radiator-revivers/BORC/Mechanical/BORC_Explode_1.PNG

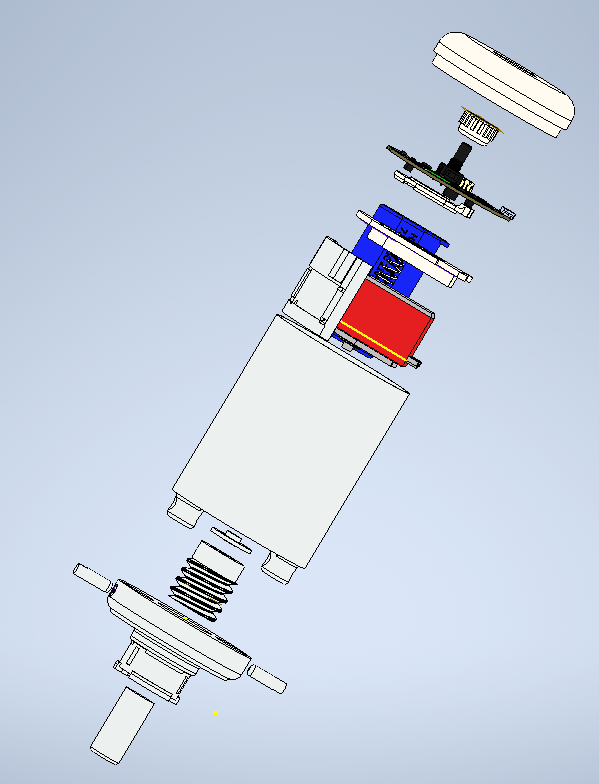
Mechanical/BORC_Explode_1.PNG
