radiator-revivers/BORC/Mechanical/BORC_Assembled.PNG

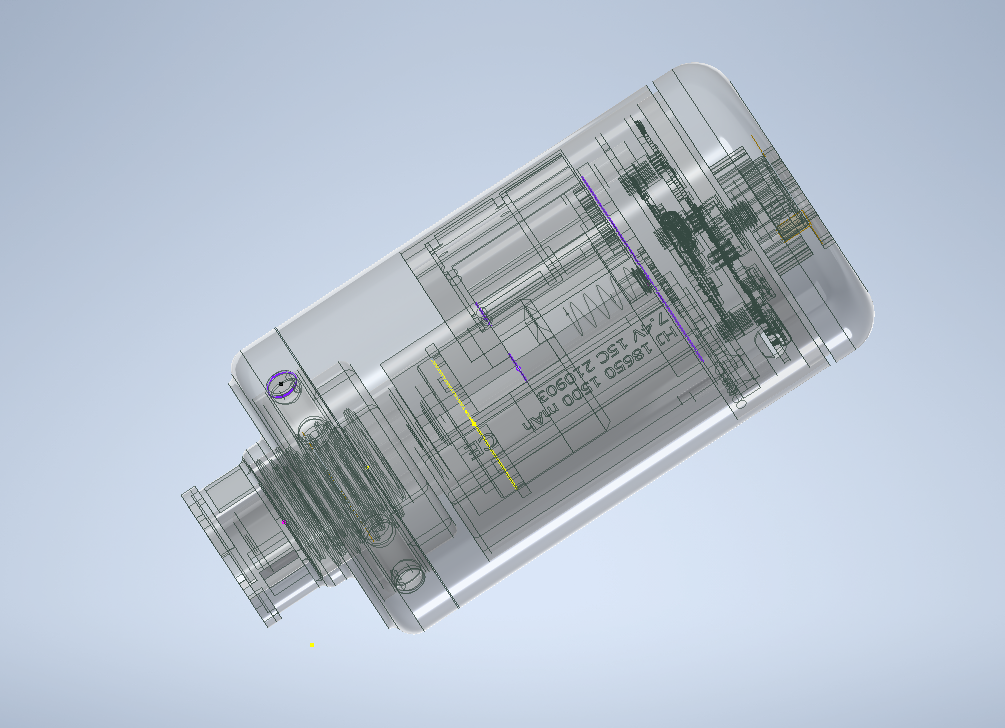
Mechanical/BORC_Assembled.PNG
