radiator-revivers/BORC/hardware/control_board/BORC_v2_control_board_render_top.png

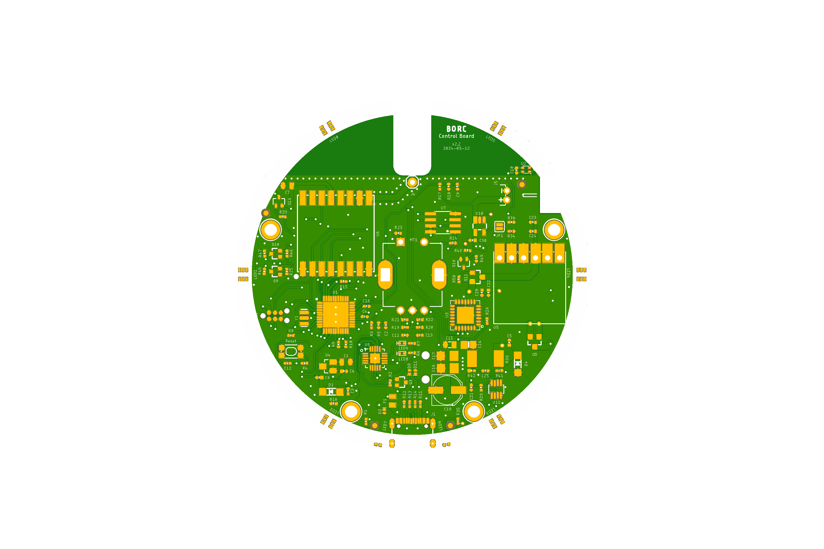
hardware/control_board/BORC_v2_control_board_render_top.png
