radiator-revivers/BORC/Mechanical/BORC_Explode.PNG

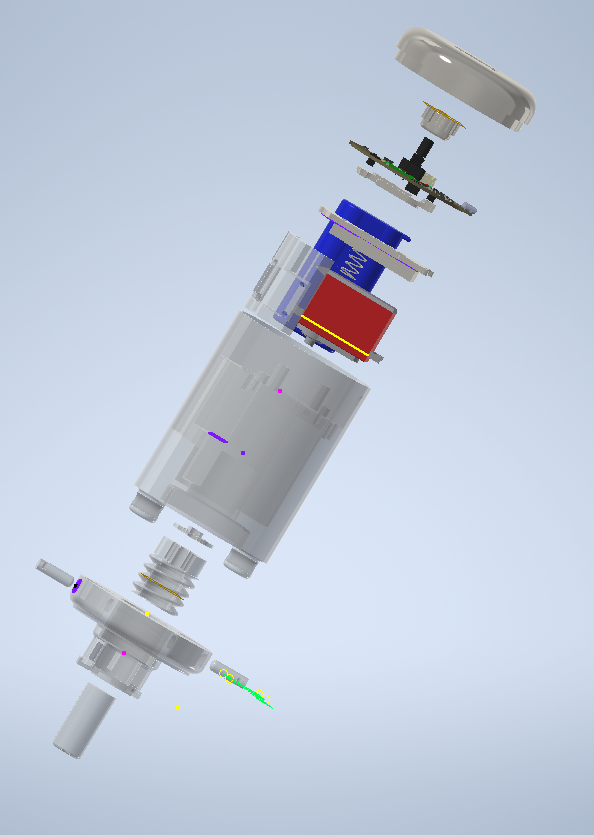
Mechanical/BORC_Explode.PNG
