radiator-revivers/BORC/hardware/control_board/BORC_v2_control_board__BOM.xlsx

Parts | Qty | Value | Manufacturer | MPN | Description
J4 | 1 |  |  |  | 915 MHz right angled helical spring antenna, 17.5 mm/0.68", 2.15 dBi gain, 50Ω impedance
R39 | 1 | 0.1/1%/2W | Vishay Dale | RCWE2512R100FKEA | 100 mOhms ±1% 2W Chip Resistor 2512 (6432 Metric) Automotive AEC-Q200, Current Sense, Moisture Resistant Thick Film
C14 | 1 | 0.1uF | YAGEO | CC0805KRX7R9BB104 | 0.1 µF ±10% 50V Ceramic Capacitor X7R 0805 (2012 Metric)
C2, C3, C4, C5, C6, C9, C10, C11, C12, C13, C18, C21, C25 | 13 | 0.1uF | Murata Electronics | GRM155R71H104KE14D | 0.1 µF ±10% 50V Ceramic Capacitor X7R 0402 (1005 Metric)
C1, C7 | 2 | 0.33µF | Murata Electronics | GRM219R71H334KA88D | 0.33 µF ±10% 50V Ceramic Capacitor X7R 0805 (2012 Metric)
R41, R42 | 2 | 10 | YAGEO | RC0402FR-0710RL | 10 Ohms ±1% 0.063W, 1/16W Chip Resistor 0402 (1005 Metric) Moisture Resistant Thick Film
R4 | 1 | 100 | YAGEO | RC0402FR-07100RL | 100 Ohms ±1% 0.063W, 1/16W Chip Resistor 0402 (1005 Metric) Moisture Resistant Thick Film
C19 | 1 | 100uF | KEMET | A768EB107M1ELAS036 | 100 µF 25 V Aluminum - Polymer Capacitors Radial, Can - SMD 36mOhm 2000 Hrs @ 125°C
R2, R8, R15, R16, R19, R20, R21, R22, R23, R24, R25, R29, R35, R45, R46, R47, R49, R50 | 18 | 10K | YAGEO | RC0402FR-7W10KL | 10 kOhms ±1% 0.125W, 1/8W Chip Resistor 0402 (1005 Metric) Moisture Resistant Thick Film
R3, R5, R17, R18 | 4 | 10M | YAGEO | RC0402FR-0710ML | 10 MOhms ±1% 0.063W, 1/16W Chip Resistor 0402 (1005 Metric) Moisture Resistant Thick Film
C15 | 1 | 10uF | Murata Electronics | GRM21BR61H106KE43L | 10 µF ±10% 50V Ceramic Capacitor X5R 0805 (2012 Metric)
C8, C20, C22, C23, C24, C30 | 5 | 10uF | Murata Electronics | GRM21BR61H106KE43L | 10 µF ±10% 50V Ceramic Capacitor X5R 0805 (2012 Metric)
Y1 | 1 | 16 MHz | Murata Electronics | CSTNE16M0V530000R0 | 16 MHz Ceramic Resonator Built in Capacitor 15 pF ±0.3% 40 Ohms -40°C ~ 85°C Surface Mount
R1, R6, R7, R33, R48 | 5 | 1K | YAGEO | RC0402FR-071KL | 1 kOhms ±1% 0.063W, 1/16W Chip Resistor 0402 (1005 Metric) Moisture Resistant Thick Film
R34, R36 | 2 | 2K | YAGEO | RC0402FR-072KL | 2 kOhms ±1% 0.063W, 1/16W Chip Resistor 0402 (1005 Metric) Moisture Resistant Thick Film
C16, C17 | 2 | 2.2uF | KEMET | C1206C225K5RAC7800 | 2.2 µF ±10% 50V Ceramic Capacitor X7R 1206 (3216 Metric)
R26 | 1 | 220 | YAGEO | RC0402FR-13220RL | 220 Ohms ±1% 0.063W, 1/16W Chip Resistor 0402 (1005 Metric) Moisture Resistant Thick Film
R13, R14 | 2 | 27 | YAGEO | RC0402FR-0727RL | 27 Ohms ±1% 0.063W, 1/16W Chip Resistor 0402 (1005 Metric) Moisture Resistant Thick Film
R9, R10 | 2 | 4.7K | YAGEO | RC0402FR-074K7L | 4.7 kOhms ±1% 0.063W, 1/16W Chip Resistor 0402 (1005 Metric) Moisture Resistant Thick Film
R11, R12 | 2 | 5.1K | YAGEO | RC0402FR-135K1L | 5.1 kOhms ±1% 0.063W, 1/16W Chip Resistor 0402 (1005 Metric) Thick Film
F1 | 1 | 6V 1.1A | Bourns Inc. | MF-PSML110/6-2 | Polymeric PTC Resettable Fuse 6V 1.1 A Ih Surface Mount 0805 (2012 Metric), Concave
U6 | 1 | 915MHz | HOPERF | RFM69HCW | HOPERF RFM69H ISM Transceiver Module General ISM 915MHz Surface Mount
LED0, LED1, LED2, LED3, LED4, LED5 | 6 | APA102-2020 | Shenzhen LED Color Opto Electronic CO.,LTD | APA102-2020 | APA102-2020 Super LED/DotStar Pixels
U7 | 1 | W25X40CLSNIG | Winbond Electronics | W25X40CLSNIG | FLASH Memory IC 4Mbit SPI 104 MHz 8-SOIC
U1 | 1 | ATMEGA1284P-MU | Microchip Technology | ATMEGA1284P-MU | AVR AVR® ATmega Microcontroller IC 8-Bit 20MHz 128KB (64K x 16) FLASH 44-VQFN (7x7)
Q3, Q9, Q10 | 3 | BSS138PW,115 | Nexperia USA Inc. | BSS138PW,115 | N-Channel 60 V 320mA (Ta) 260mW (Ta), 830mW (Tc) Surface Mount SOT-323
U8 | 1 | FT231XQ-R | FTDI, Future Technology Devices International Ltd | FT231XQ-R | USB Bridge, USB to UART USB 2.0 UART Interface 20-QFN (4x4)
LED8 | 1 | GREEN | Inolux | IN-S42ATG | Green 525nm LED Indication - Discrete 3.3V 0402 (1005 Metric)
U11 | 1 | INA219AIDCNR | Texas Instruments | INA219AIDCNR | Current Monitor Regulator High-Side 10mA SOT-23-8
J3 | 1 | M20-8900405 | Harwin Inc. | M20-8900405 | Connector Header Surface Mount, Right Angle 4 position 0.100" (2.54mm)
D4 | 1 | 60V, 2A | SMC Diode Solutions | MBR260HW | Diode 60 V 2A Surface Mount SOD-123
D1 | 1 | 40V, 1A | STMicroelectronics | STPS140Z | Diode 40 V 1A Surface Mount SOD-123
U4 | 1 | 3.3V, 250mA | Microchip Technology | MCP1703T-3302E/CB | Linear Voltage Regulator IC Positive Fixed 1 Output 250mA SOT-23A-3
U10 | 1 | MCP73831T-2ACI/OT | Microchip Technology | MCP73831T-2ACI/OT | Charger IC Lithium Ion/Polymer SOT-23-5
U3 | 1 | PCA9685 | NXP USA Inc. | PCA9685BS,118 | LED Driver IC 16 Output Linear PWM Dimming 25mA 28-HVQFN (6x6)
MT1 | 1 | PEC11R-4215F-S0024 | Bourns Inc. | PEC11R-4215F-S0024 | Rotary Encoder Mechanical 24 Quadrature (Incremental) Vertical
U5 | 1 | 4012 | Pololu Corporation | U3V40F5 | Non-Isolated PoL Module DC DC Converter 1 Output 5V 3.5A 1.3V - 5V Input
J2 | 1 | 4 POS 1mm | JST Sales America Inc. | SM04B-SRSS-TB(LF)(SN) | Connector Header Surface Mount, Right Angle 4 position 0.039" (1.00mm)
LED6, LED7 | 2 | RED | Inolux | IN-S42ATR | Red 631nm LED Indication - Discrete 2.1V 0402 (1005 Metric)
J5 | 1 | 2 POS 2.0mm | JST Sales America Inc. | S2B-PH-K-S | Connector Header Through Hole, Right Angle 2 position 0.079" (2.00mm)
U2 | 1 | SHT40-BD1B | Sensirion AG | SHT40-BD1B-R3 | Humidity, Temperature 0 ~ 100% RH I²C ±1.8% RH 6 s Surface Mount
D2, D9, D11 | 3 | SP0402U-ULC-01ETG | Littelfuse Inc. | SP0402U-ULC-01ETG | 9.2V (Typ) Clamp 2A (8/20µs) Ipp Tvs Diode Surface Mount 0402/2DFN (1x0.60)
SW1 | 1 | SPST-NO 50mA 32V | C&K | KMR221GLFS | Tactile Switch SPST-NO Top Actuated Surface Mount
Q5, Q11 | 2 | P-CH 30V 4A SOT23F | Toshiba Semiconductor and Storage | SSM3J374R,LF | P-Channel 30 V 4A (Ta) 1W (Ta) Surface Mount SOT-23F
Q16 | 1 | BJT NPN 40V 0.2A | Rohm Semiconductor | UMT3904T106 | Bipolar (BJT) Transistor NPN 40 V 200 mA 300MHz 200 mW Surface Mount UMT3
Q14 | 1 | BJT PNP 40V 0.2A | Rohm Semiconductor | UMT3906T106 | Bipolar (BJT) Transistor PNP 40 V 200 mA 250MHz 200 mW Surface Mount UMT3
J1 | 1 | CONN RCP USB2.0 TYP C 24P SMD RA | GCT | USB4105-GF-A | USB-C (USB TYPE-C) USB 2.0 Receptacle Connector 24 (16+8 Dummy) Position Surface Mount, Right Angle; Through Hole
LED9 | 1 | YELLOW | Inolux | IN-S42ATY | Yellow 592nm LED Indication - Discrete 1.9V 0402 (1005 Metric)
