radiator-revivers/BORC/hardware/LED_Board/LED_Board_BOM.xlsx

Parts | Qty | Value | Manufacturer | MPN | Description
LED1, LED2, LED3, LED4, LED5, LED6, LED7, LED8, LED9, LED10, LED11, LED12, LED13, LED14, LED15, LED16, LED17, LED18, LED19, LED20, LED21, LED22, LED23, LED24, LED25, LED26, LED27, LED28, LED29, LED30, LED31, LED32, LED33, LED34, LED35, LED36, LED37, LED38, LED39, LED40, LED41, LED42, LED43, LED44, LED45, LED46, LED47, LED48, LED49, LED50, LED51, LED52, LED53, LED54, LED55, LED56, LED57, LED58, LED59, LED60, LED61, LED62, LED63, LED64, LED65, LED66, LED67, LED68, LED69, LED70, LED71, LED72, LED73, LED74, LED75, LED76, LED77, LED78, LED79, LED80, LED81, LED82, LED83, LED84, LED85, LED86, LED87, LED88, LED89, LED90, LED91, LED92, LED93, LED94, LED95, LED96, LED97, LED98, LED99, LED100, LED101, LED102, LED103, LED104, LED105 | 105 | White | Inolux | IN-S42ATUW | White LED Indication - Discrete 3.1V 0402 (1005 Metric)
C1, C2 | 2 | 0.1uF | Murata Electronics | GRM155R71C104KA88J | 0.1 µF ±10% 16V Ceramic Capacitor X7R 0402 (1005 Metric)
R1, R2, R3, R4 | 4 | 10K | YAGEO | RC0402FR-7W10KL | 10 kOhms ±1% 0.125W, 1/8W Chip Resistor 0402 (1005 Metric) Moisture Resistant Thick Film
C3, C7 | 2 | 10uF | Murata Electronics | GRM155R71C104KA88J | 0.1 µF ±10% 16V Ceramic Capacitor X7R 0402 (1005 Metric)
U1 | 1 | LED Driver | Lumissil Microsystems | IS31FL3731-QFLS2-TR | LED Driver IC 18 Output Linear Analog Dimming 34mA 28-QFN (4x4)
J2 | 1 | QWIIC_RIGHT_ANGLE | JST Sales America Inc. | SM04B-SRSS-TB(LF)(SN) | Connector Header Surface Mount, Right Angle 4 position 0.039" (1.00mm)
