radiator-revivers/BORC/hardware/control_board/BORC_v2_control_board__schematic.pdf

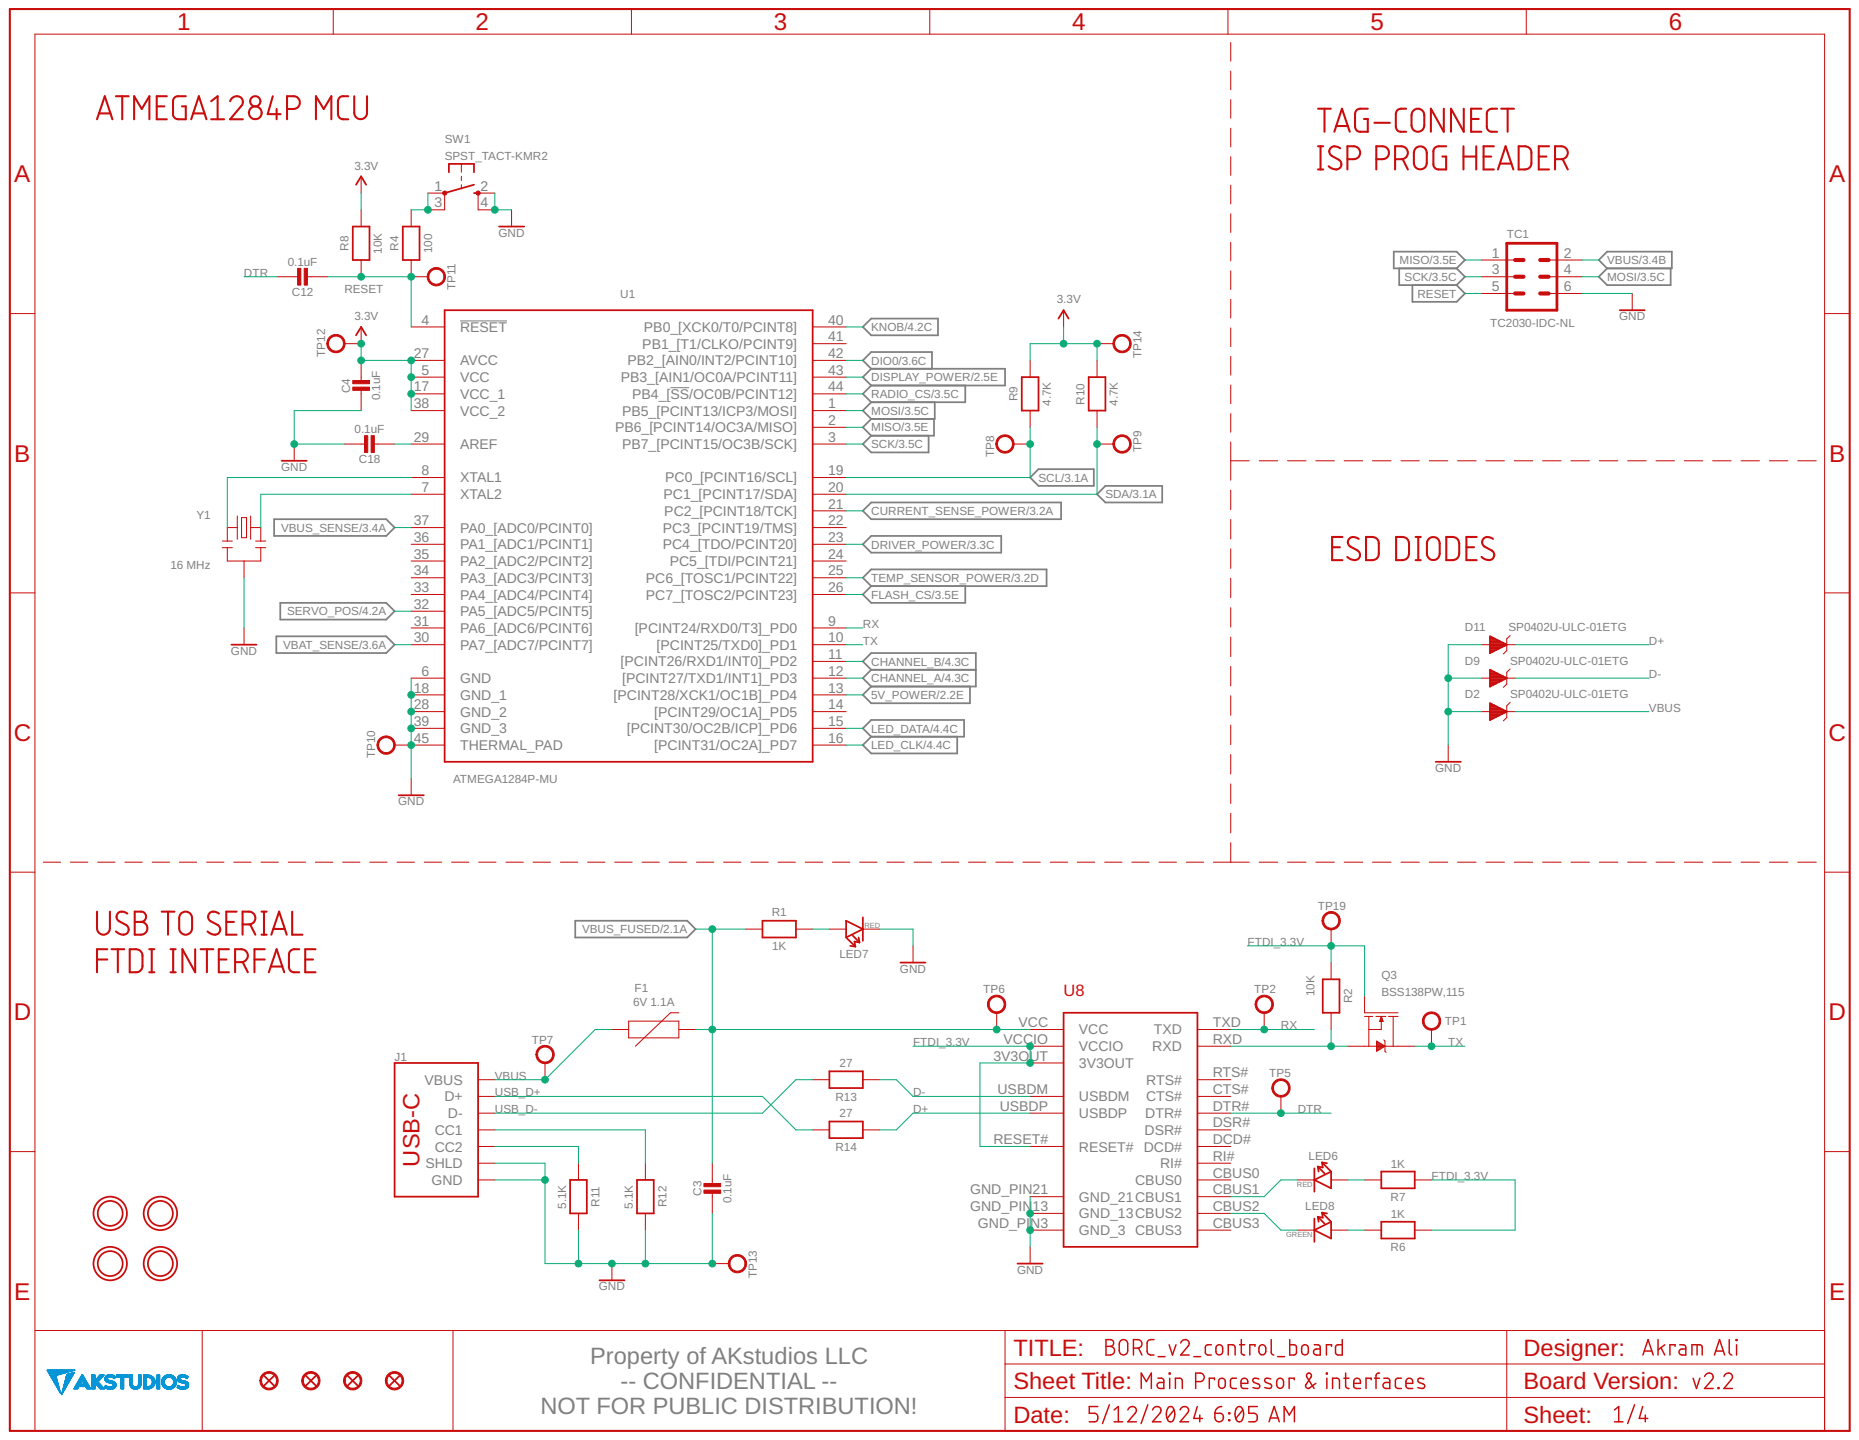
[picture p6: page 1]

Property of AKstudios LLC -- CONFIDENTIAL -- NOT FOR PUBLIC DISTRIBUTION!

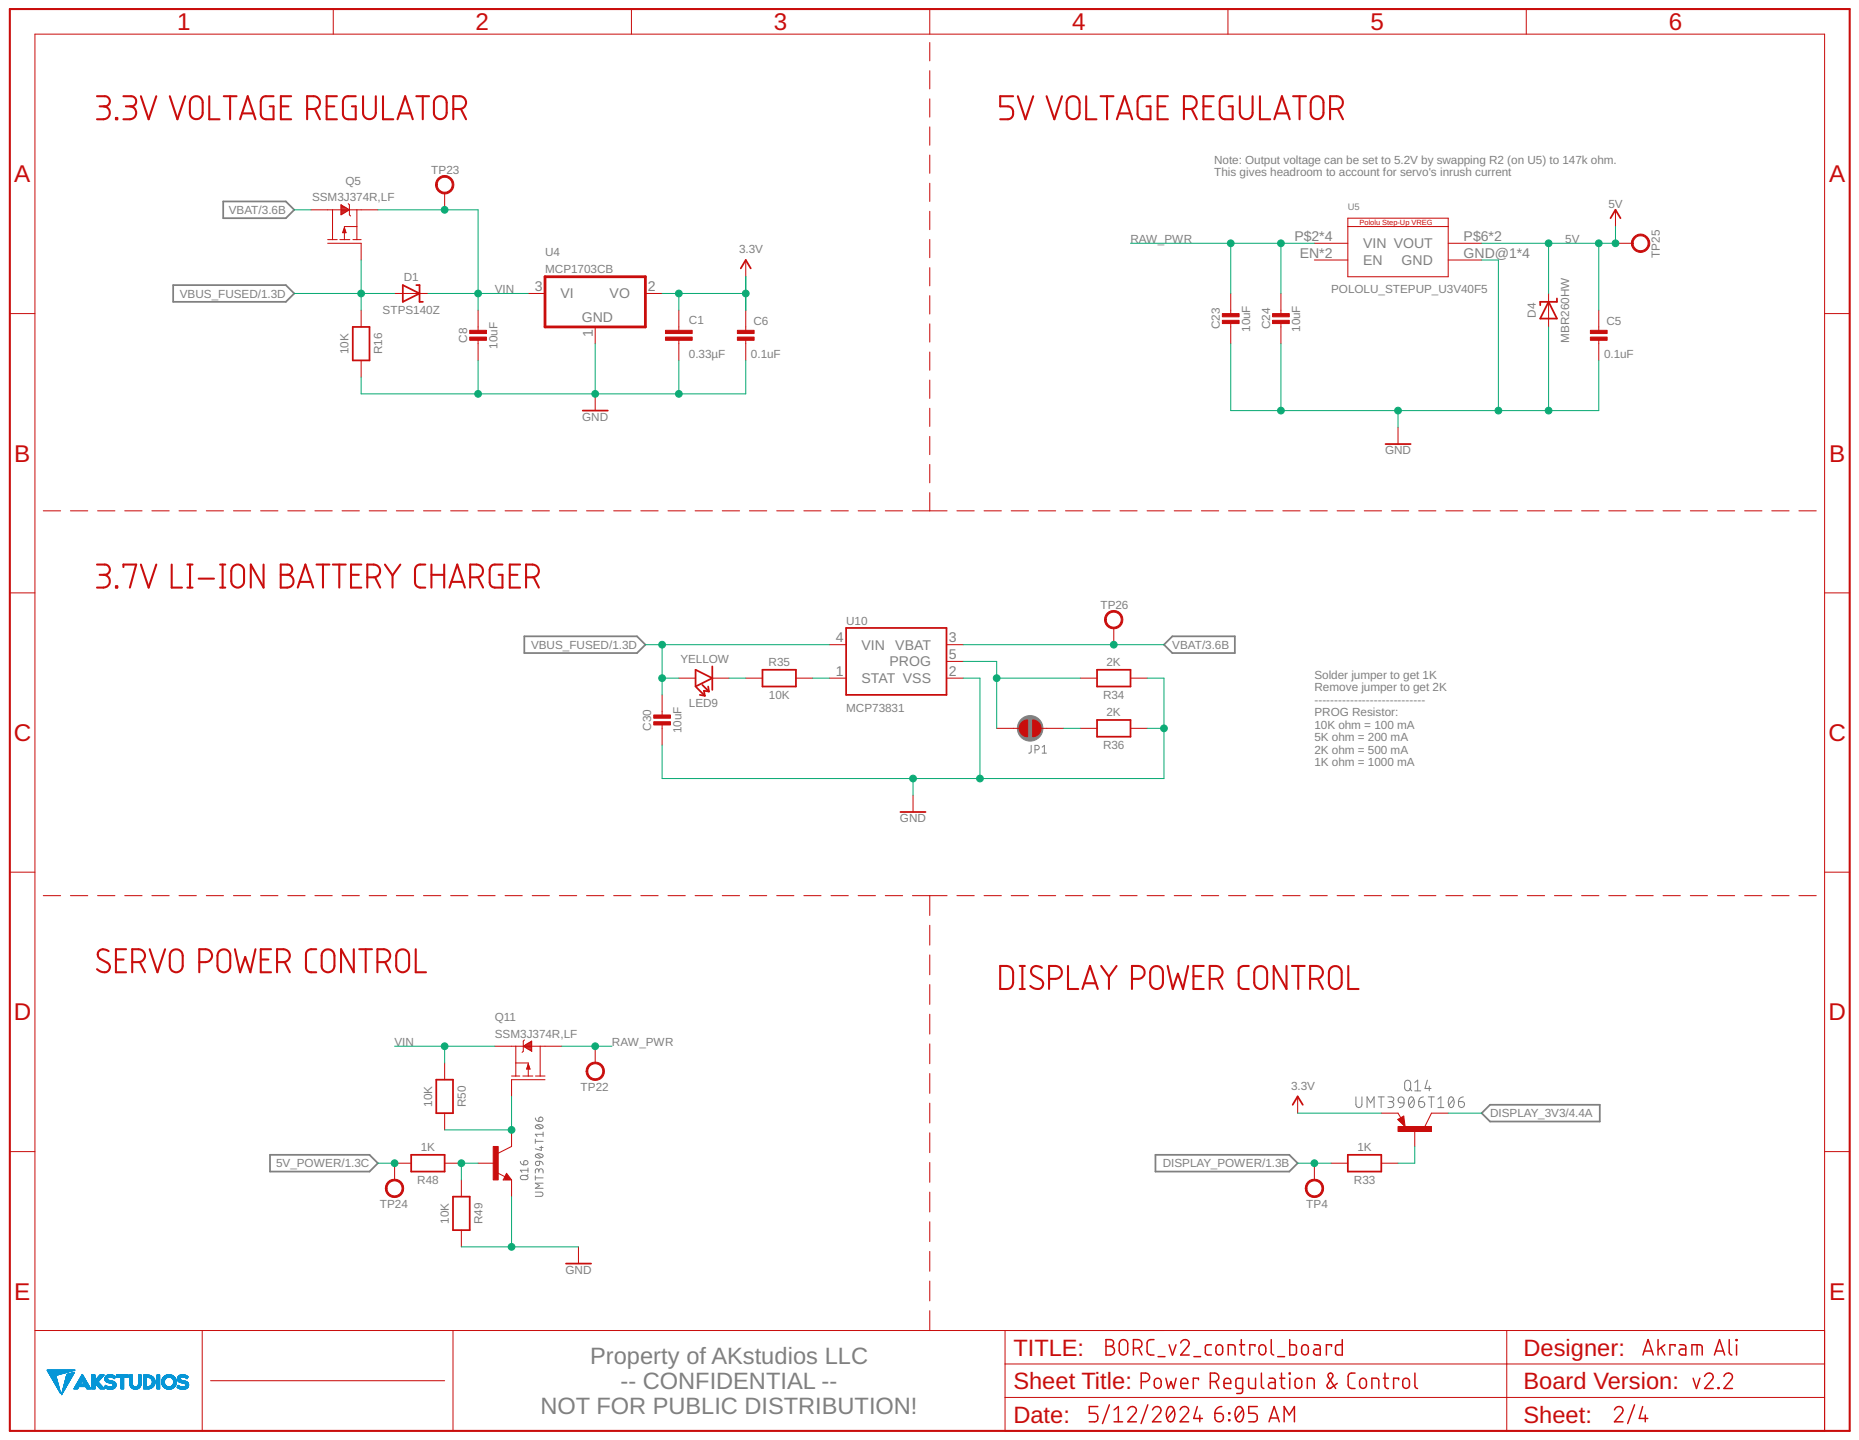
[picture p7: page 2]

Note: Output voltage can be set to 5.2V by swapping R2 (on U5) to 147k ohm. This gives headroom to account for servo's inrush current

Pololu Step-Up VREG

Solder jumper to get 1K Remove jumper to get 2K

---------------------------- PROG Resistor: 10K ohm = 100 mA

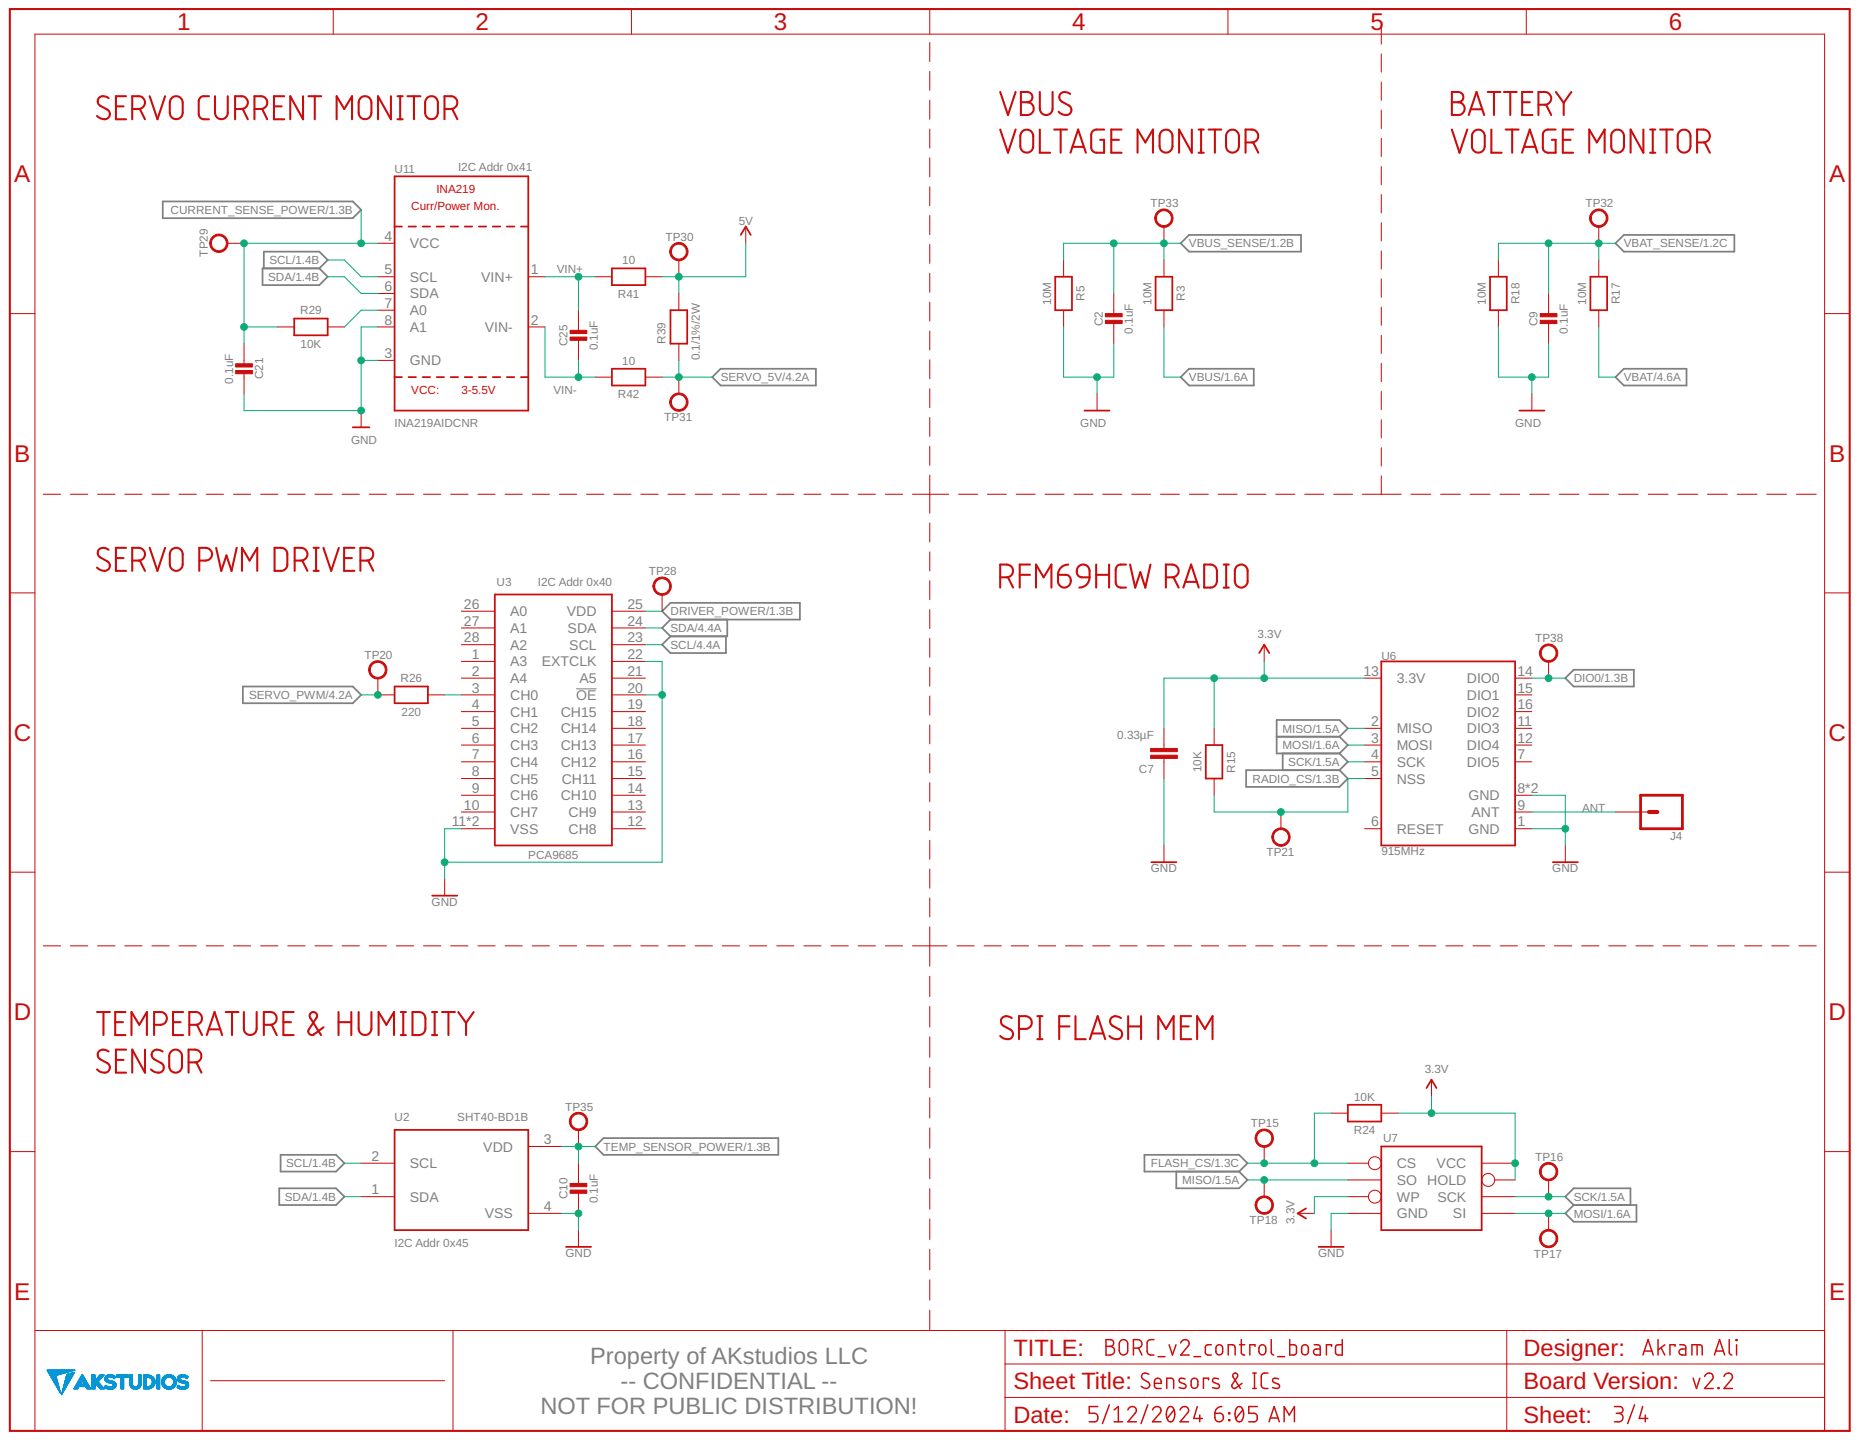
[picture p8: page 3]

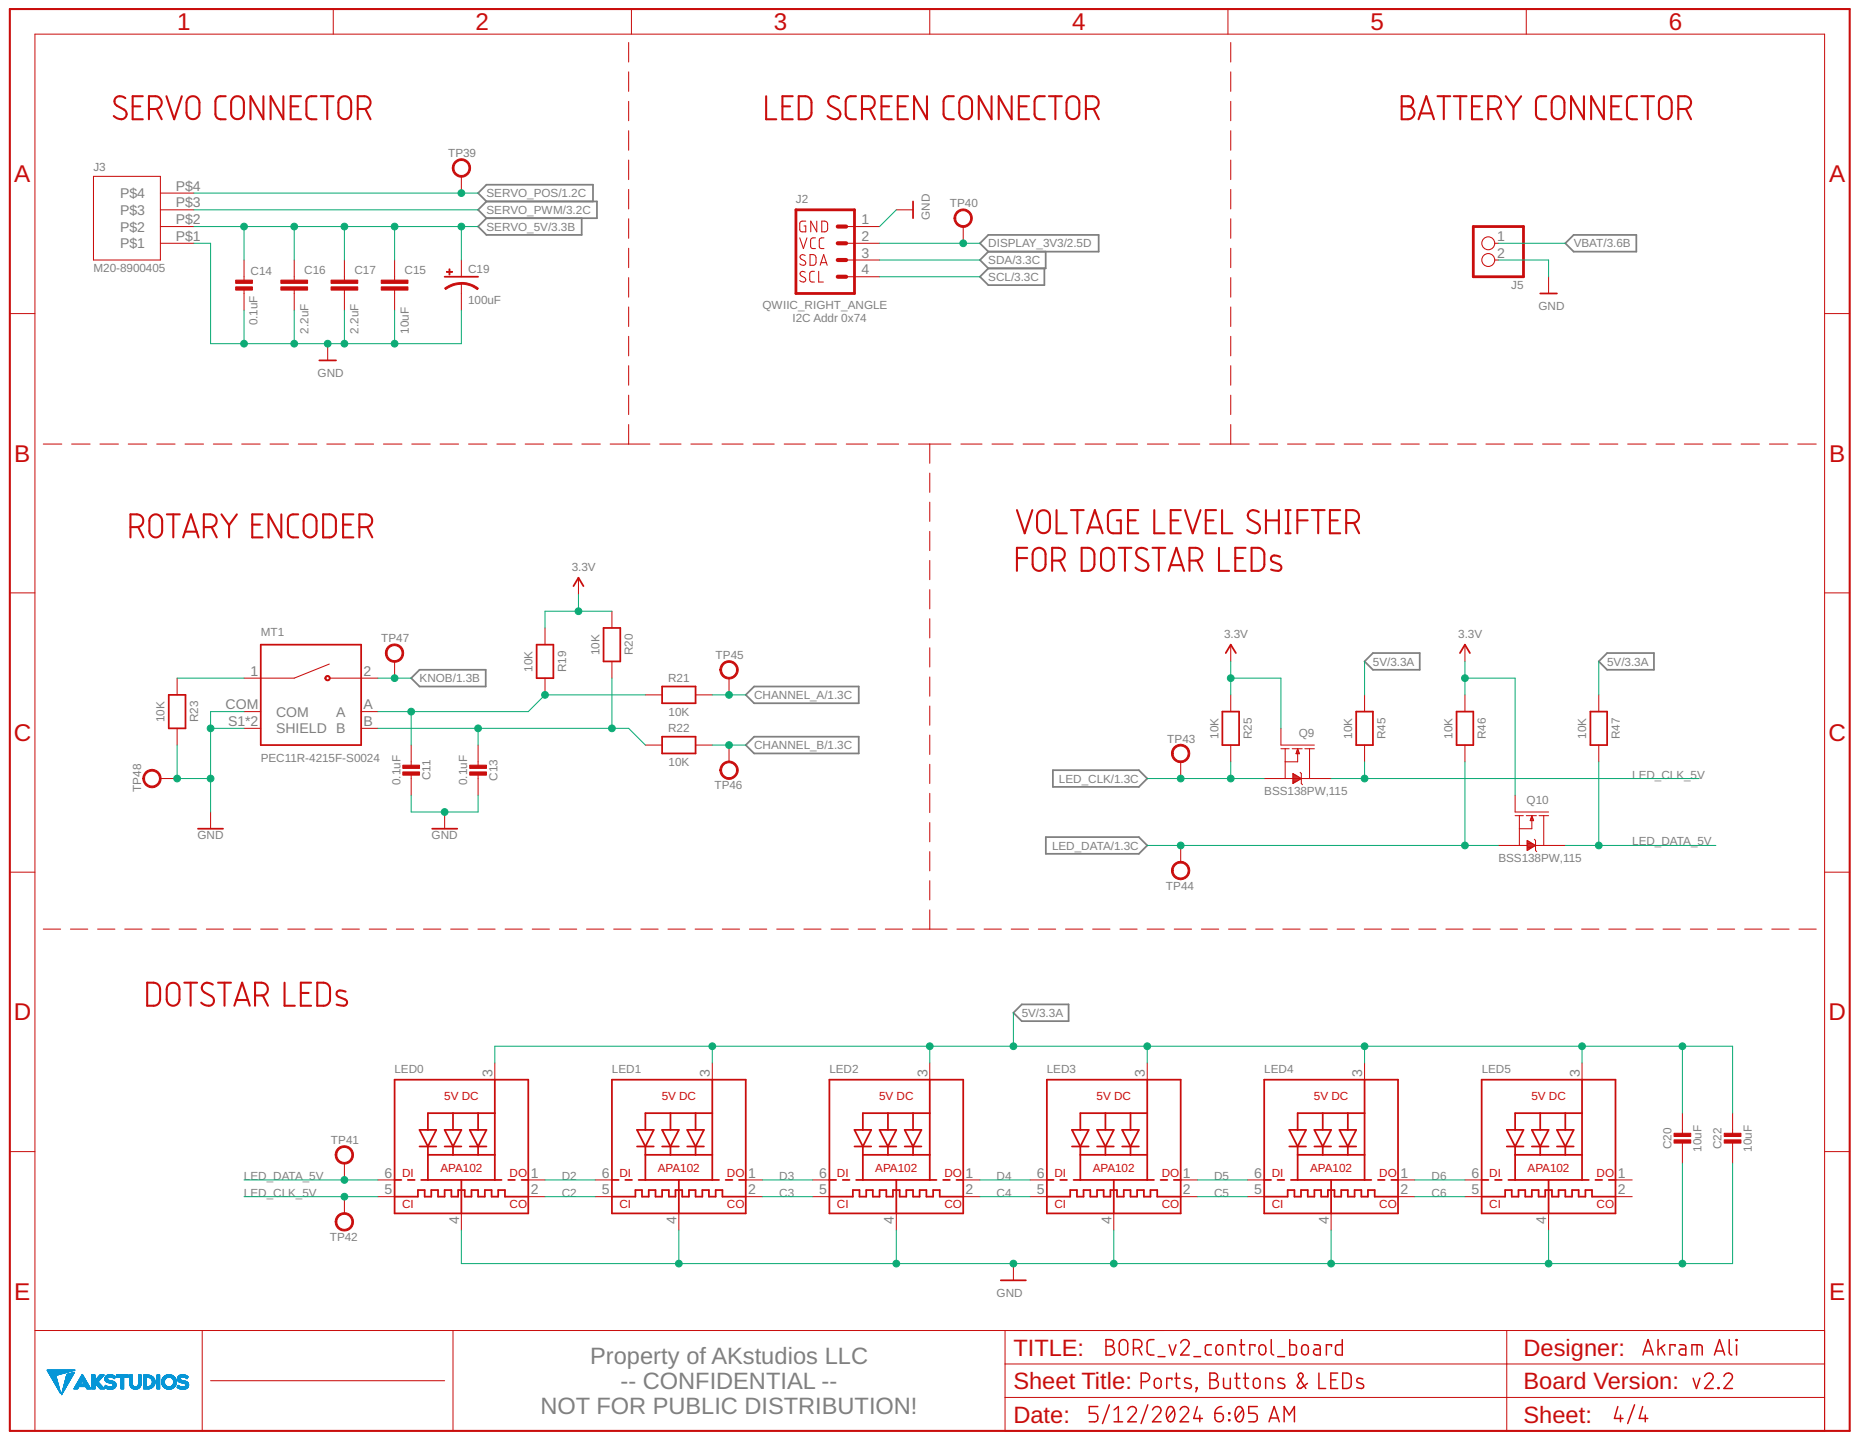
[picture p9: page 4]
