radiator-revivers/BORC/hardware/control_board/BORC_v2_control_board__dimensions.pdf

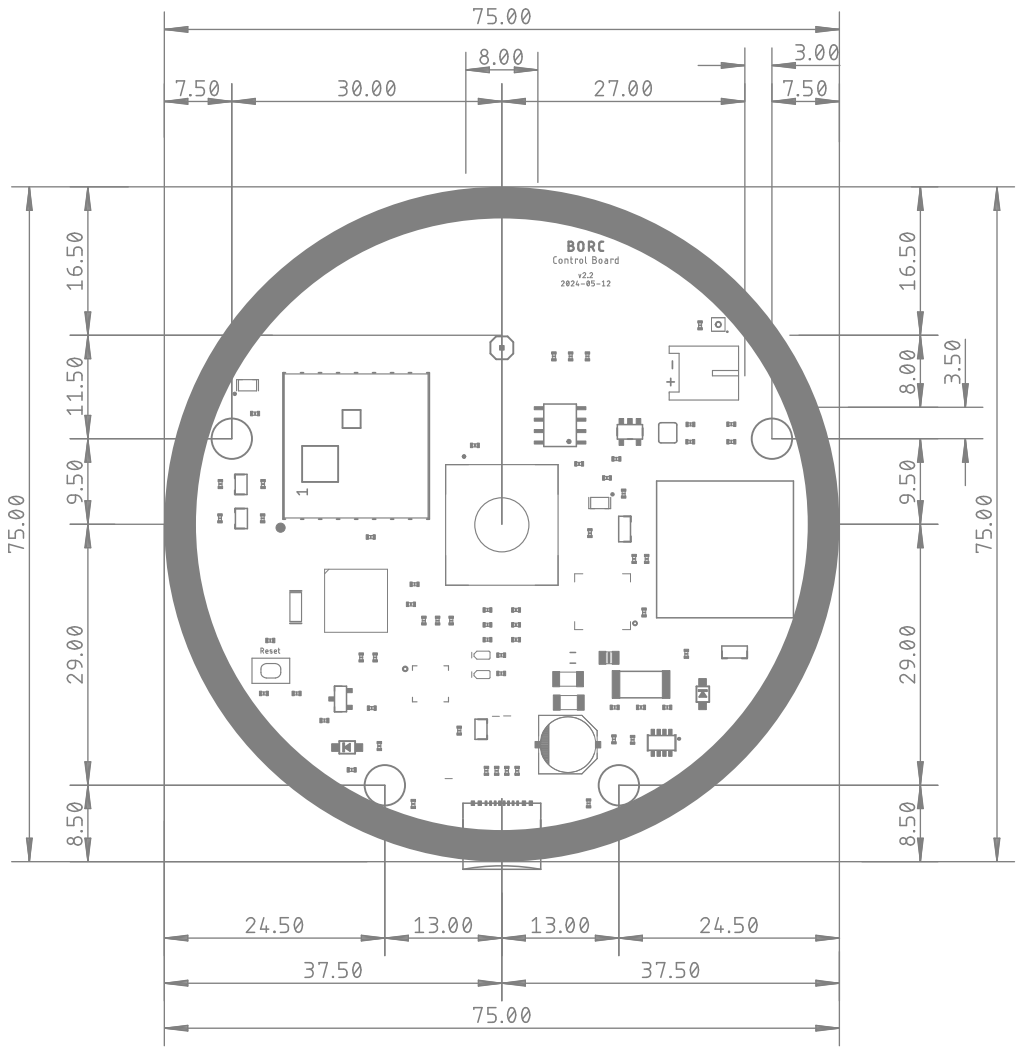
[picture p10: page 1]
