radiator-revivers/BORC/hardware/control_board/BORC_v2_control_board.brd

## EAGLE design hardware/control_board/BORC_v2_control_board.brd (2024-05-12)

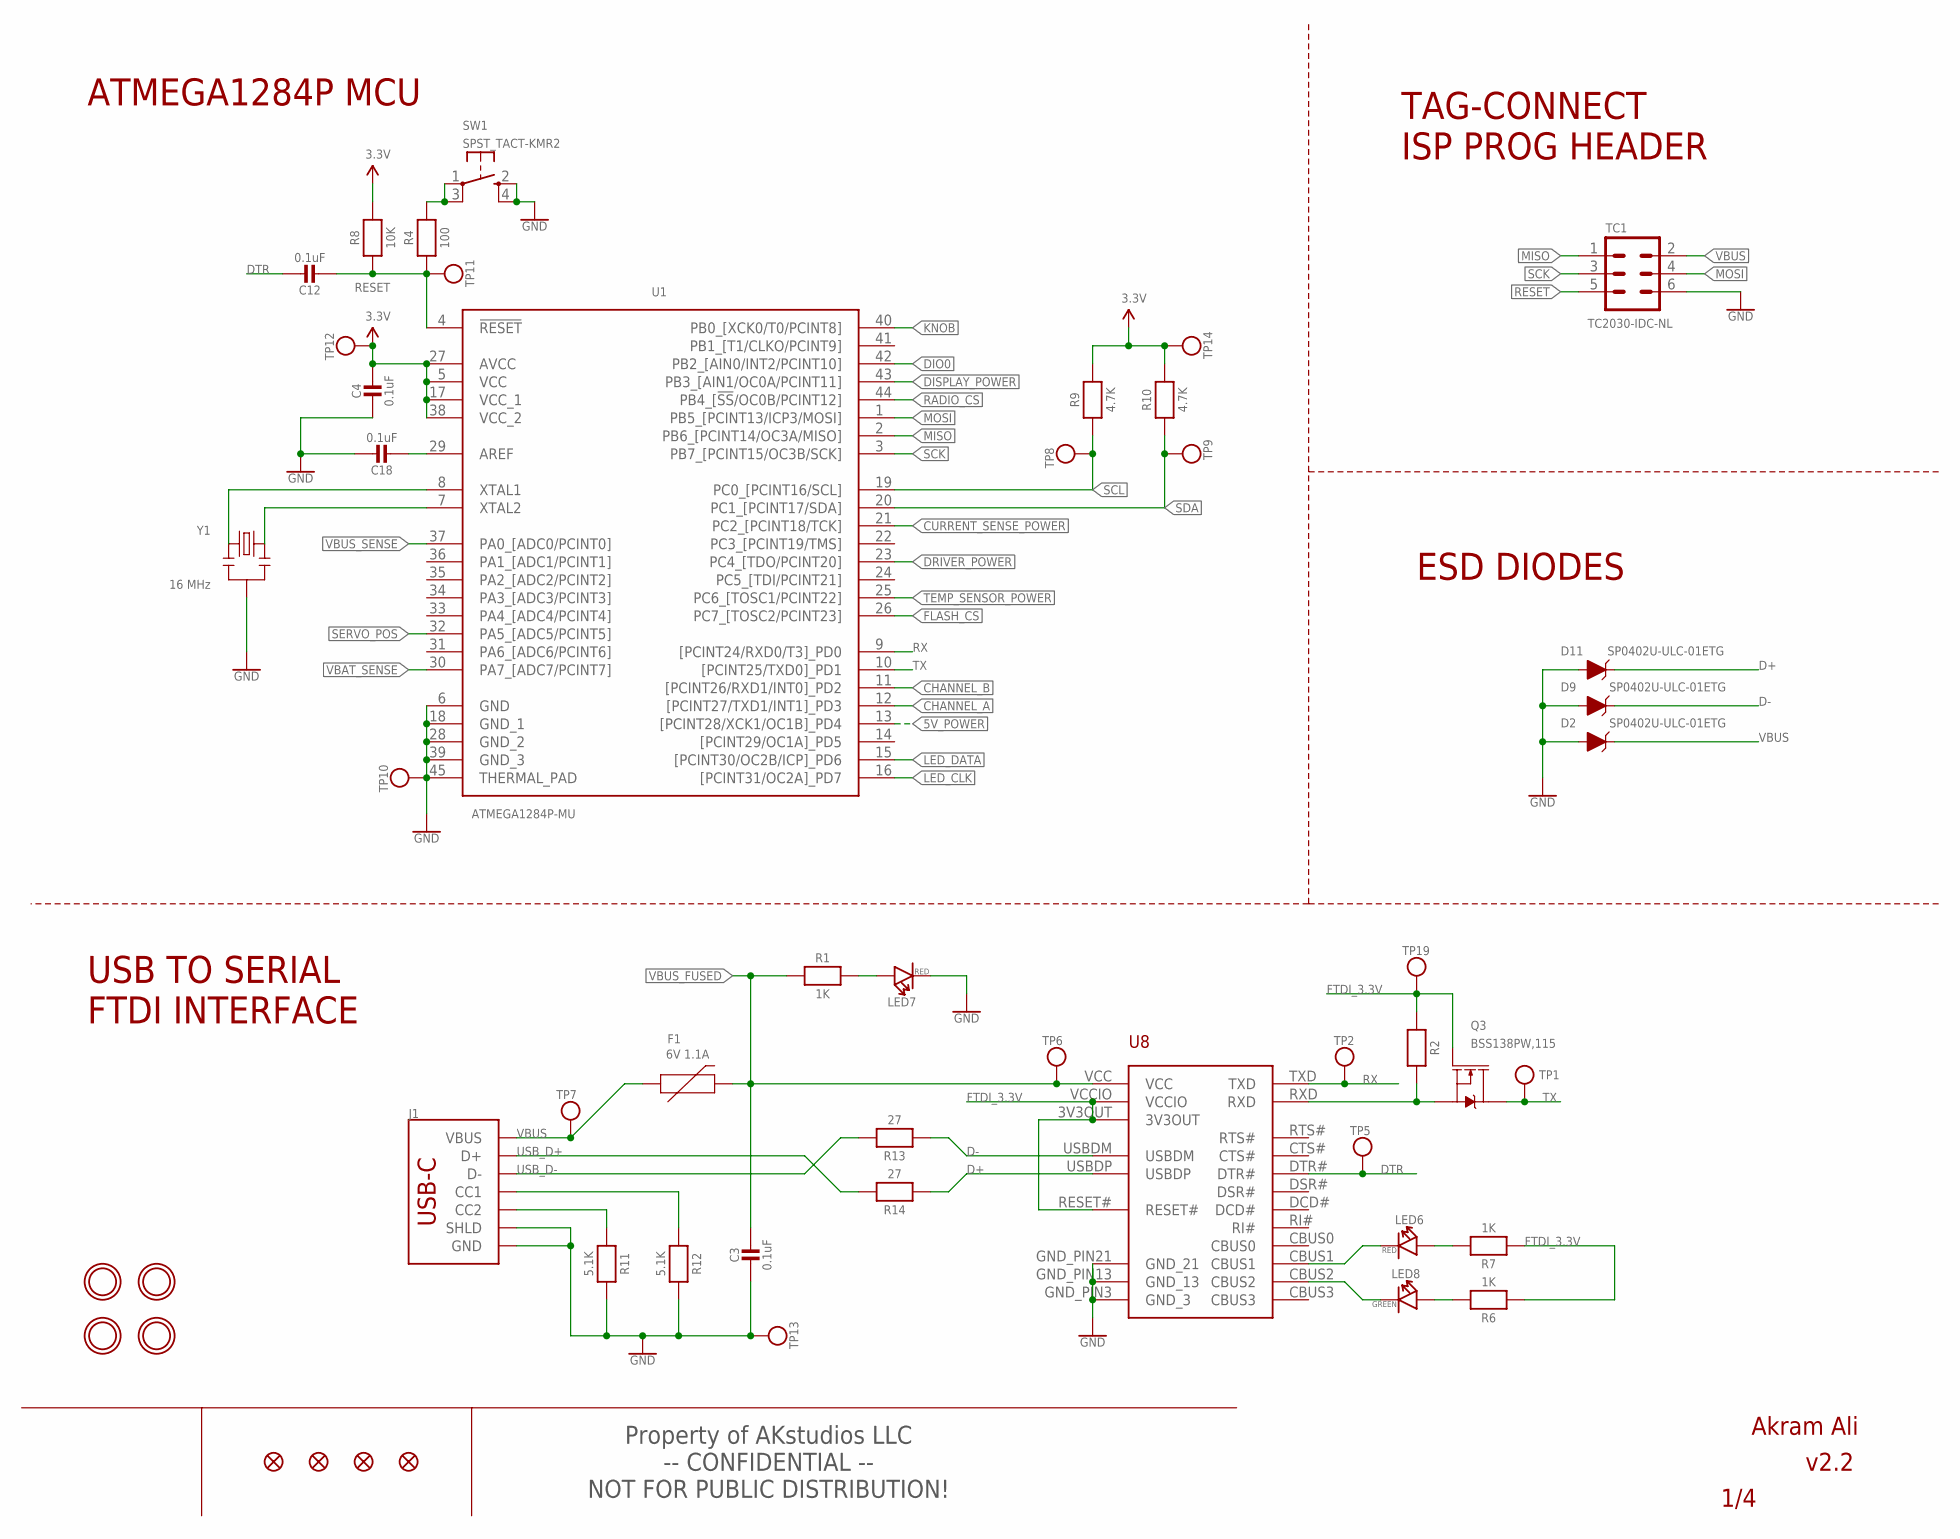
[picture p11: schematic BORC_v2_control_board.sch, sheet 1, Main Processor & interfaces]

Parts:
C3, C4, C12, C18: 0.1uF; MICROBUILDER__0402MP; MPN GRM155R71H104KE14D
D2, D9, D11: SP0402U-ULC-01ETG; 0402; MPN SP0402U-ULC-01ETG
F1: 6V 1.1A; 0805; MPN MF-PSML110/6-2
FID1, FID2, FID3, FID4: FIDUCIAL""; FIDUCIAL_1MM
J1: USB Female Type C Connector; USB-C-16P-2LAYER-PADS; MPN USB4105-GF-A
LED6, LED7: RED; LED-0402; MPN IN-S42ATR
LED8: GREEN; LED-0402; MPN IN-S42ATG
Q3: BSS138PW,115; SOT323; MPN BSS138PW,115
R1, R6, R7: 1K; MICROBUILDER__0402MP; MPN RC0402FR-071KL
R2, R8: 10K; MICROBUILDER__0402MP; MPN RC0402FR-7W10KL
R4: 100; MICROBUILDER__0402MP; MPN RC0402FR-07100RL
R9, R10: 4.7K; MICROBUILDER__0402MP; MPN RC0402FR-074K7L
R11, R12: 5.1K; MICROBUILDER__0402MP; MPN RC0402FR-135K1L
R13, R14: 27; MICROBUILDER__0402MP; MPN RC0402FR-0727RL
SW1: SPST_TACT-KMR2; KMR2; MPN KMR221GLFS
TC1: TC2030-IDC-NL
TP1: TX; MICROBUILDER_TESTPOINT_ROUND_1MM
TP2, TP5, TP6, TP7, TP8, TP9, TP10, TP11, TP12, TP13, TP14, TP19: RX; MICROBUILDER_TESTPOINT_ROUND_1MM
U1: ATMEGA1284P-MU; QFN50P700X700X100-45N; MPN ATMEGA1284P-MU
U8: FT231XQ-R; FTDI_FT231XQ-R_PACKAGE
U$8, U$9, U$10, U$11: MICROBUILDER_MOUNTINGHOLE2.5_THICK; MICROBUILDER_MOUNTINGHOLE_2.5_PLATED_THICK
Y1: 16 MHz; RESONATOR-SMD; MPN CSTNE16M0V530000R0

Connections:
5V_POWER: U1.13 ([PCINT28/XCK1/OC1B]_PD4); also elsewhere on the board
CHANNEL_A: U1.12 ([PCINT27/TXD1/INT1]_PD3); also elsewhere on the board
CHANNEL_B: U1.11 ([PCINT26/RXD1/INT0]_PD2); also elsewhere on the board
CURRENT_SENSE_POWER: U1.21 (PC2_[PCINT18/TCK]); also elsewhere on the board
D+: D11.C, R14.1, U8.USBDP
D-: D9.C, R13.1, U8.USBDM
DIO0: U1.42 (PB2_[AIN0/INT2/PCINT10]); also elsewhere on the board
DISPLAY_POWER: U1.43 (PB3_[AIN1/OC0A/PCINT11]); also elsewhere on the board
DRIVER_POWER: U1.23 (PC4_[TDO/PCINT20]); also elsewhere on the board
DTR: C12.1, TP5.P$1, U8.DTR#
FLASH_CS: U1.26 (PC7_[TOSC2/PCINT23]); also elsewhere on the board
FTDI_3.3V: Q3.1 (G), R2.1, R6.1, R7.1, TP19.P$1, U8.3V3OUT, U8.RESET#, U8.VCCIO
GND: C3.2, C4.2, C18.1, D2.A, D9.A, D11.A, J1.GND, J1.GND2 (GND), J1.SHLD1 (SHLD), J1.SHLD2 (SHLD), J1.SHLD3 (SHLD), J1.SHLD4 (SHLD), LED7.-, R11.2, R12.2, SW1.2 (S), SW1.4 (S1), TC1.6, TP10.P$1, TP13.P$1, U1.6 (GND), U1.18 (GND_1), U1.28 (GND_2), U1.39 (GND_3), U1.45 (THERMAL_PAD), U8.GND_PIN3 (GND_3), U8.GND_PIN13 (GND_13), U8.GND_PIN21 (GND_21), Y1.2; also elsewhere on the board
KNOB: U1.40 (PB0_[XCK0/T0/PCINT8]); also elsewhere on the board
LED_CLK: U1.16 ([PCINT31/OC2A]_PD7); also elsewhere on the board
LED_DATA: U1.15 ([PCINT30/OC2B/ICP]_PD6); also elsewhere on the board
MISO: TC1.1, U1.2 (PB6_[PCINT14/OC3A/MISO]); also elsewhere on the board
MOSI: TC1.4, U1.1 (PB5_[PCINT13/ICP3/MOSI]); also elsewhere on the board
unnamed: U1.8 (XTAL1), Y1.1
unnamed: LED7.+, R1.2
unnamed: U1.7 (XTAL2), Y1.3
unnamed: J1.B5 (CC2), R11.1
unnamed: J1.A5 (CC1), R12.1
unnamed: LED8.+, R6.2
unnamed: LED6.-, U8.CBUS1
unnamed: C18.2, U1.29 (AREF)
unnamed: LED8.-, U8.CBUS2
unnamed: R4.2, SW1.1, SW1.3 (P1)
unnamed: Q3.2 (S), R2.2, U8.RXD
unnamed: LED6.+, R7.2
RADIO_CS: U1.44 (PB4_[!SS!/OC0B/PCINT12]); also elsewhere on the board
RESET: C12.2, R4.1, R8.1, TC1.5, TP11.P$1, U1.4 (!RESET)
RX: TP2.P$1, U1.9 ([PCINT24/RXD0/T3]_PD0), U8.TXD
SCK: TC1.3, U1.3 (PB7_[PCINT15/OC3B/SCK]); also elsewhere on the board
SCL: R9.1, TP8.P$1, U1.19 (PC0_[PCINT16/SCL]); also elsewhere on the board
SDA: R10.1, TP9.P$1, U1.20 (PC1_[PCINT17/SDA]); also elsewhere on the board
SERVO_POS: U1.32 (PA5_[ADC5/PCINT5]); also elsewhere on the board
TEMP_SENSOR_POWER: U1.25 (PC6_[TOSC1/PCINT22]); also elsewhere on the board
TX: Q3.3 (D), TP1.P$1, U1.10 ([PCINT25/TXD0]_PD1)
USB_D+: J1.A6 (D+), J1.B6 (D+), R14.2
USB_D-: J1.A7 (D-), J1.B7 (D-), R13.2
VBAT_SENSE: U1.30 (PA7_[ADC7/PCINT7]); also elsewhere on the board
VBUS: D2.C, F1.1, J1.VBUS1 (VBUS), J1.VBUS2 (VBUS), TC1.2, TP7.P$1; also elsewhere on the board
VBUS_FUSED: C3.1, F1.2, R1.1, TP6.P$1, U8.VCC; also elsewhere on the board
VBUS_SENSE: U1.37 (PA0_[ADC0/PCINT0]); also elsewhere on the board
VCC: C4.1, R8.2, R9.2, R10.2, TP12.P$1, TP14.P$1, U1.5 (VCC), U1.17 (VCC_1), U1.27 (AVCC), U1.38 (VCC_2); also elsewhere on the board

Notes on the sheet:
-- CONFIDENTIAL -- NOT FOR PUBLIC DISTRIBUTION!
Property of AKstudios LLC
v2.2
Akram Ali
ATMEGA1284P MCU
TAG-CONNECT ISP PROG HEADER
USB TO SERIAL FTDI INTERFACE
ESD DIODES

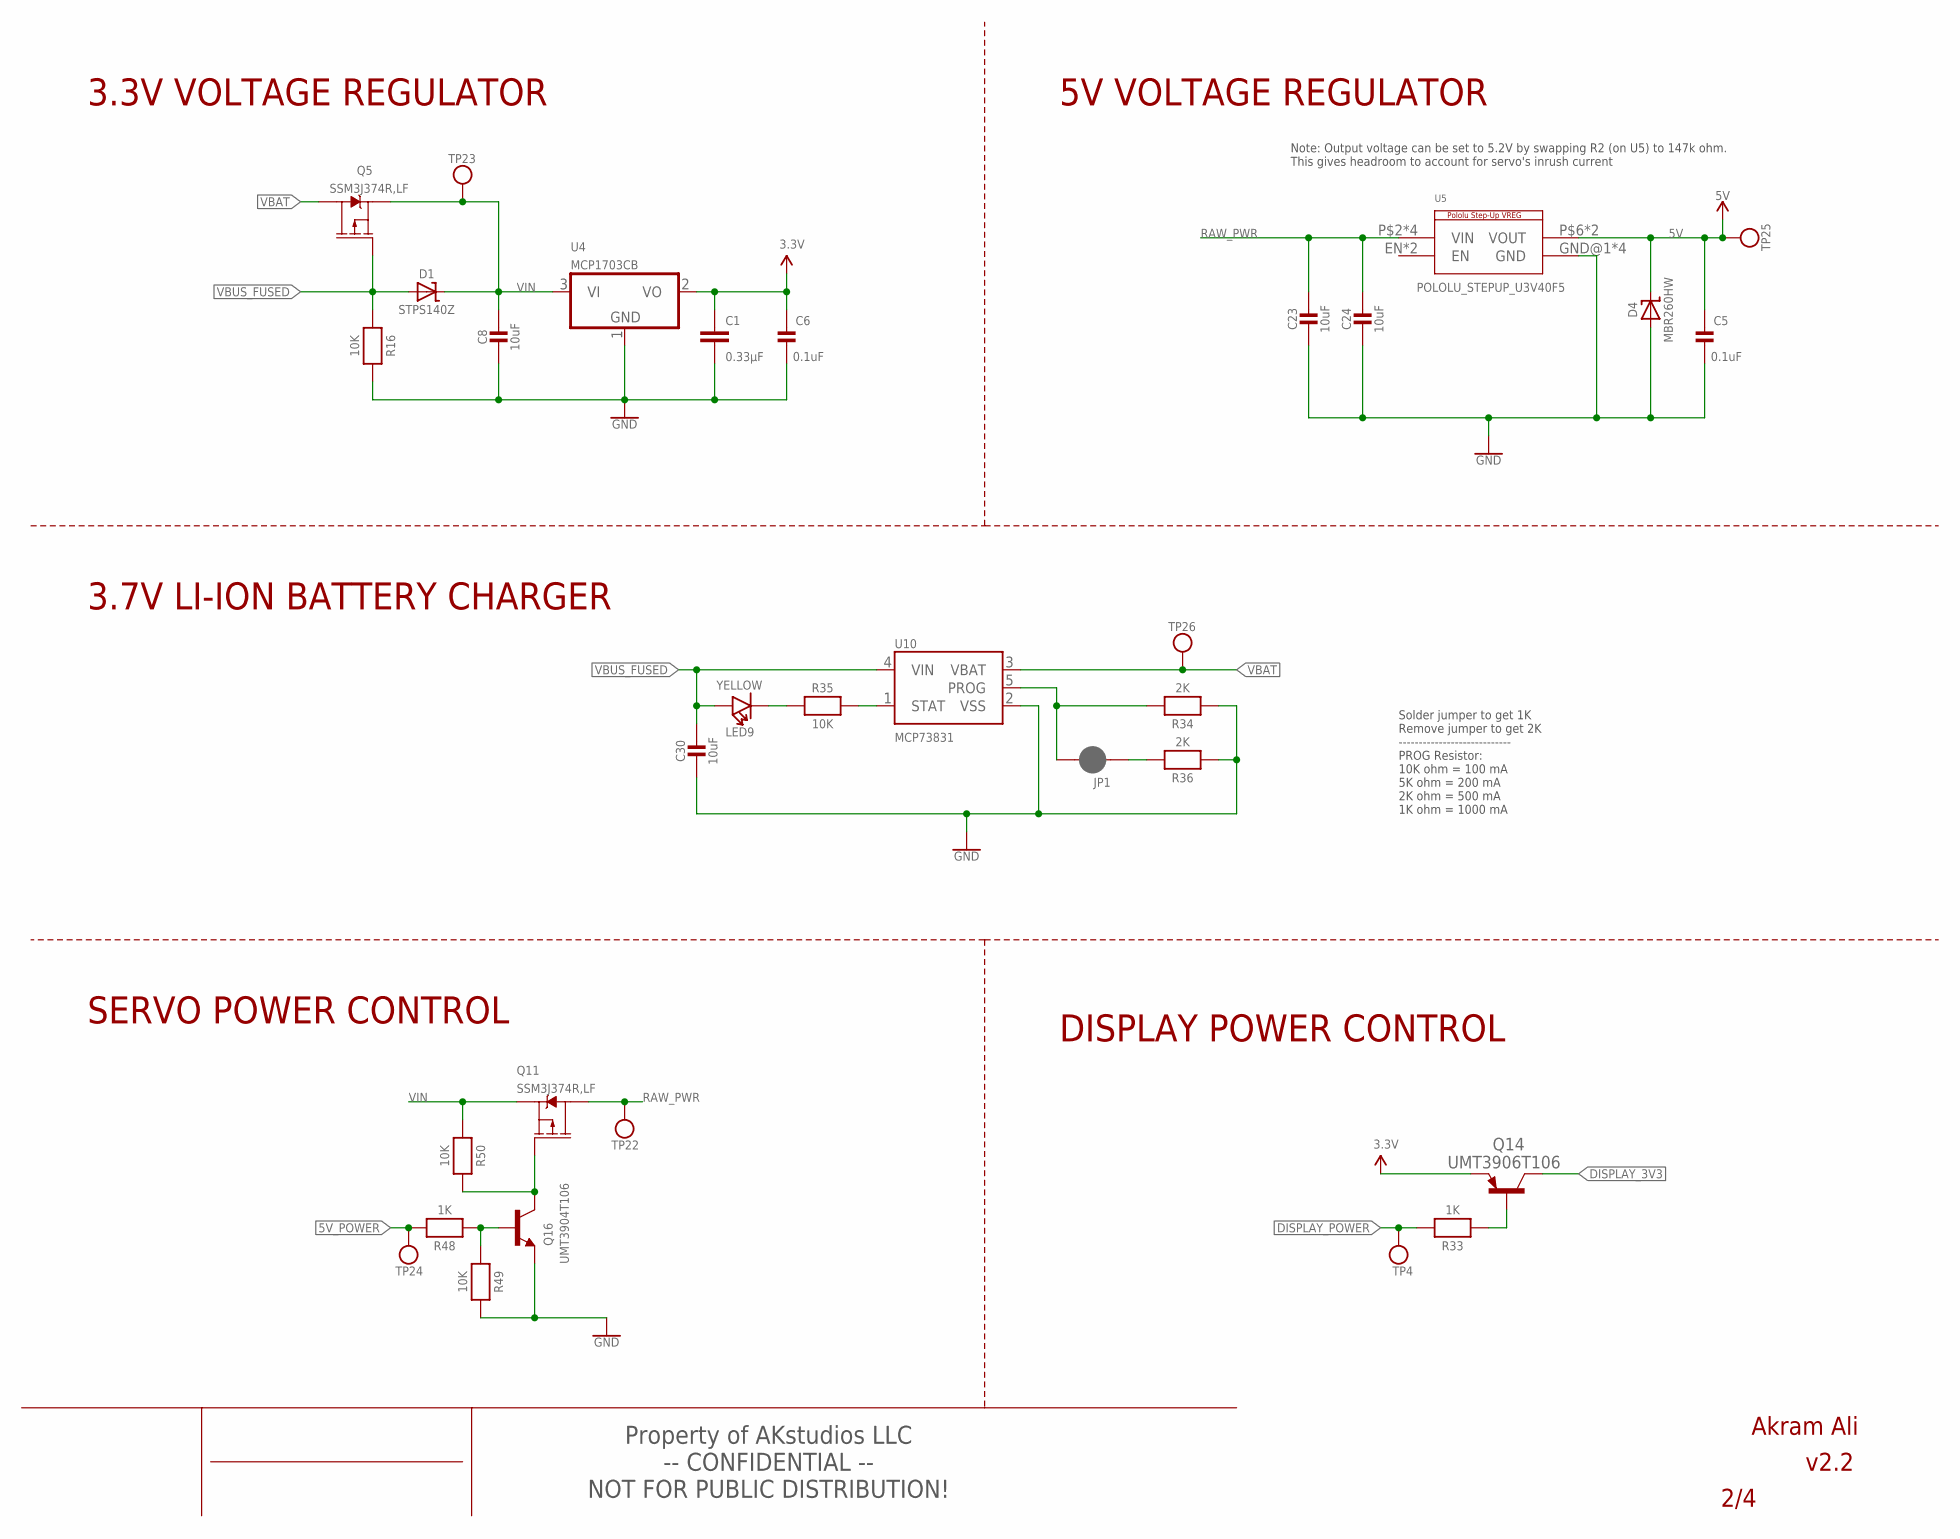
[picture p12: schematic BORC_v2_control_board.sch, sheet 2, Power Regulation & Control]

Parts:
C1: 0.33µF; 0805; MPN GRM219R71H334KA88D
C5, C6: 0.1uF; MICROBUILDER__0402MP; MPN GRM155R71H104KE14D
C8, C23, C24: 10uF; MICROBUILDER__0402MP; MPN GRM155R71H104KE14D
C30: 10uF; MICROBUILDER__0402MP; MPN GRM155R61A106ME11D
D1: STPS140Z; SOD-123; MPN STPS140Z
D4: MBR260HW; SOD-123; MPN MBR260HW
JP1: JUMPER-SMT_2_NC_PASTE_SILK; SMT-JUMPER_2_NC_PASTE_SILK
LED9: YELLOW; LED-0402; MPN IN-S42ATY
Q5, Q11: SSM3J374R,LF; SOT23-3; MPN SSM3J374R,LF
Q14: UMT3906T106; SOT65P210X100-3N-PNP; MPN UMT3906T106
Q16: UMT3904T106; SOT65P210X100-3N; MPN UMT3904T106
R16, R35, R49, R50: 10K; MICROBUILDER__0402MP; MPN RC0402FR-7W10KL
R33, R48: 1K; MICROBUILDER__0402MP; MPN RC0402FR-071KL
R34, R36: 2K; MICROBUILDER__0402MP; MPN RC0402FR-072KL
TP4, TP23, TP25, TP26: RX; MICROBUILDER_TESTPOINT_ROUND_1MM
TP22: RAW_PWR; MICROBUILDER_TESTPOINT_ROUND_1MM
TP24: 5V_POWER; MICROBUILDER_TESTPOINT_ROUND_1MM
U4: MCP1703CB; SOT23; MPN MCP1703T-3302E/CB
U5: POLOLU_STEPUP_U3V40F5; POLOLU_STEPUP_U3V40X; MPN U3V40F5
U10: MCP73831; SOT23-5; MPN MCP73831T-2ACI/OT

Connections:
5V: C5.1, D4.C, TP25.P$1, U5.P$6 (VOUT), U5.VOUT; also elsewhere on the board
5V_POWER: R48.2, TP24.P$1; also elsewhere on the board
DISPLAY_3V3: Q14.3 (C); also elsewhere on the board
DISPLAY_POWER: R33.2, TP4.P$1; also elsewhere on the board
GND: C1.2, C5.2, C6.2, C8.2, C23.2, C24.2, C30.2, D4.A, Q16.2 (E), R16.2, R34.1, R36.1, R49.2, U4.1 (GND), U5.GND@1 (GND), U5.GND@2 (GND), U5.P$4 (GND), U5.P$5 (GND), U10.2 (VSS); also elsewhere on the board
unnamed: R35.2, U10.1 (STAT)
unnamed: LED9.-, R35.1
unnamed: Q14.2 (B), R33.1
unnamed: JP1.2, R34.2, U10.5 (PROG)
unnamed: JP1.1, R36.2
unnamed: Q11.1 (G1), Q16.3 (C), R50.2
unnamed: Q16.1 (B), R48.1, R49.1
RAW_PWR: C23.1, C24.1, Q11.3 (D1), TP22.P$1, U5.P$2 (VIN), U5.P$3 (VIN), U5.VIN@1 (VIN), U5.VIN@2 (VIN)
VBAT: Q5.3 (D1), TP26.P$1, U10.3 (VBAT); also elsewhere on the board
VBUS_FUSED: C30.1, D1.A, LED9.+, Q5.1 (G1), R16.1, U10.4 (VIN); also elsewhere on the board
VCC: C1.1, C6.1, Q14.1 (E), U4.2 (VO); also elsewhere on the board
VIN: C8.1, D1.C, Q5.2 (S1), Q11.2 (S1), R50.1, TP23.P$1, U4.3 (VI)

Notes on the sheet:
-- CONFIDENTIAL -- NOT FOR PUBLIC DISTRIBUTION!
Property of AKstudios LLC
v2.2
Akram Ali
3.3V VOLTAGE REGULATOR
5V VOLTAGE REGULATOR
3.7V LI-ION BATTERY CHARGER
Note: Output voltage can be set to 5.2V by swapping R2 (on U5) to 147k ohm. This gives headroom to account for servo's inrush current
SERVO POWER CONTROL
DISPLAY POWER CONTROL
Solder jumper to get 1K Remove jumper to get 2K ---------------------------- PROG Resistor: 10K ohm = 100 mA 5K ohm = 200 mA 2K ohm = 500 mA 1K ohm = 1000 mA

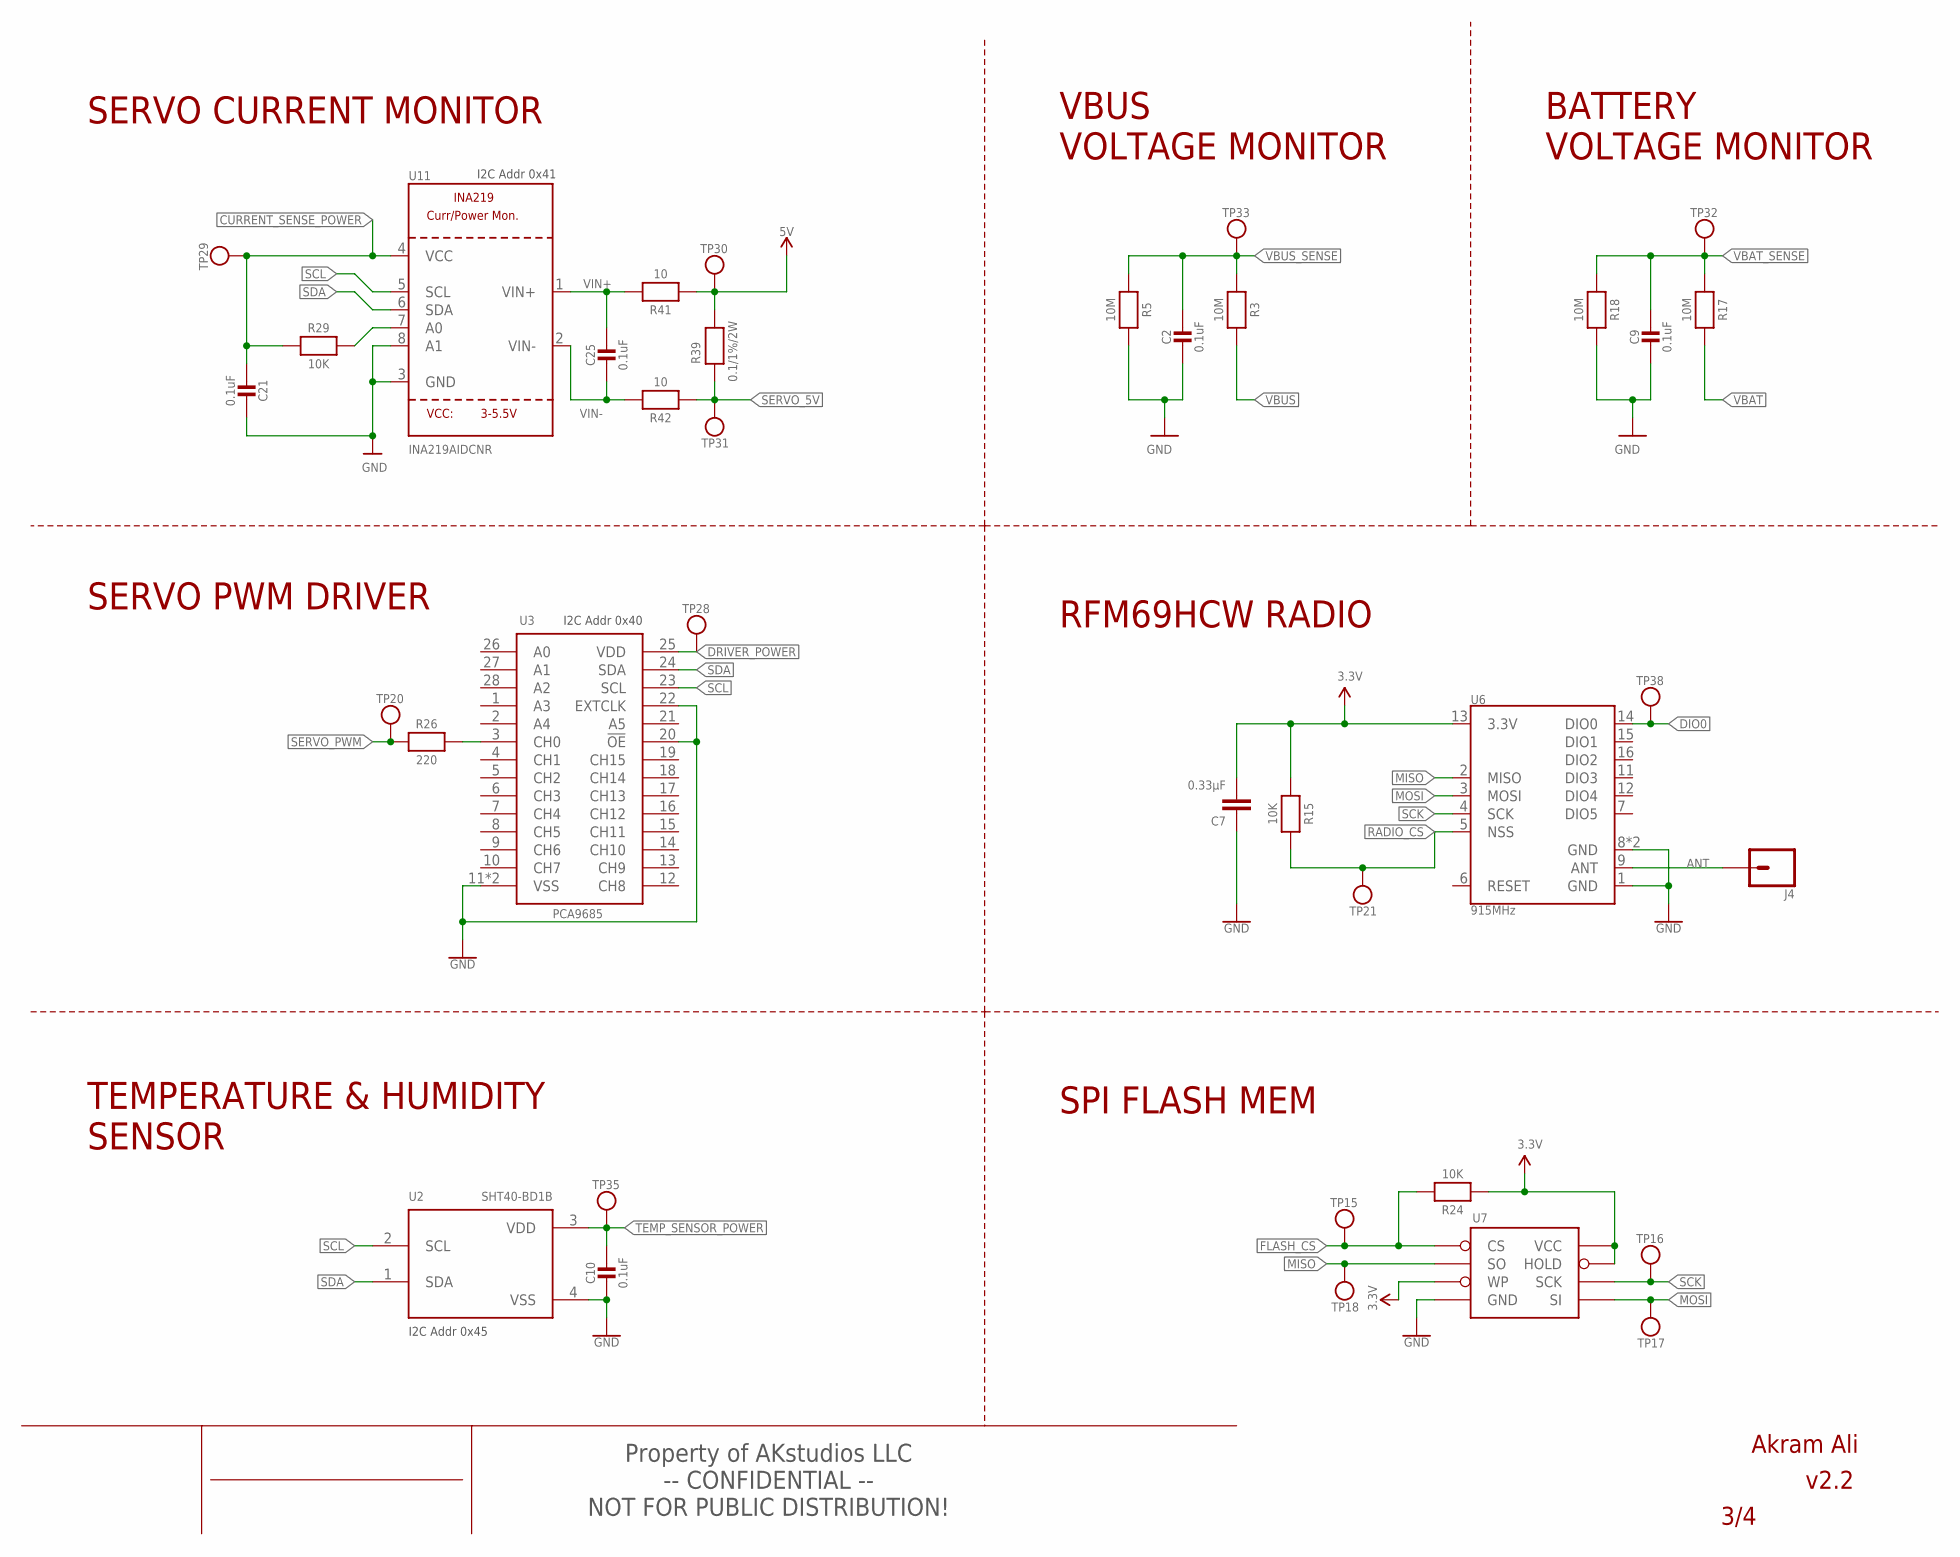
[picture p13: schematic BORC_v2_control_board.sch, sheet 3, Sensors & ICs]

Parts:
C2, C9, C10, C21, C25: 0.1uF; MICROBUILDER__0402MP; MPN GRM155R71H104KE14D
C7: 0.33µF; 0805; MPN GRM219R71H334KA88D
J4: CONN_01; 1X01
R3, R5, R17, R18: 10M; MICROBUILDER__0402MP; MPN RC0402FR-0710ML
R15, R24, R29: 10K; MICROBUILDER__0402MP; MPN RC0402FR-7W10KL
R26: 220; MICROBUILDER__0402MP; MPN RC0402FR-13220RL
R39: 0.1/1%/2W; 2512; MPN RCWE2512R100FKEA
R41, R42: 10; MICROBUILDER__0402MP; MPN RC0402FR-07100RL
TP15, TP16, TP17, TP18, TP20, TP21, TP28, TP29, TP30, TP31, TP32, TP33, TP35, TP38: RX; MICROBUILDER_TESTPOINT_ROUND_1MM
U2: SHT40-BD1B; SHT4X; MPN SHT40-BD1B-R3
U3: PCA9685; HVQFN28_SOT788-1; MPN PCA9685BS,118
U6: 915MHz; RFM69HCW-XXXS2
U7: AT25F512BJEDEC_3.9MM; SO08; MPN W25X40CLSNIG
U11: INA219AIDCNR; SOT23-8; MPN INA219AIDCNR

Connections:
5V: R39.2, R41.1, TP30.P$1; also elsewhere on the board
ANT: J4.1, U6.9 (ANT)
CURRENT_SENSE_POWER: C21.2, R29.1, TP29.P$1, U11.4 (VCC); also elsewhere on the board
DIO0: TP38.P$1, U6.14 (DIO0); also elsewhere on the board
DRIVER_POWER: TP28.P$1, U3.25 (VDD); also elsewhere on the board
FLASH_CS: R24.2, TP15.P$1, U7.1_CS (CS); also elsewhere on the board
GND: C2.2, C7.1, C9.2, C10.2, C21.1, R5.2, R18.2, U2.4 (VSS), U3.11 (VSS), U3.20 (!OE), U3.22 (EXTCLK), U3.TH (VSS), U6.1 (GND), U6.8 (GND), U6.10 (GND), U7.4_GND (GND), U11.3 (GND), U11.8 (A1); also elsewhere on the board
MISO: TP18.P$1, U6.2 (MISO), U7.2_SO (SO); also elsewhere on the board
MOSI: TP17.P$1, U6.3 (MOSI), U7.5_SI (SI); also elsewhere on the board
unnamed: R26.2, U3.3 (CH0)
unnamed: R29.2, U11.7 (A0)
RADIO_CS: R15.2, TP21.P$1, U6.5 (NSS); also elsewhere on the board
SCK: TP16.P$1, U6.4 (SCK), U7.6_SCK (SCK); also elsewhere on the board
SCL: U2.2 (SCL), U3.23 (SCL), U11.5 (SCL); also elsewhere on the board
SDA: U2.1 (SDA), U3.24 (SDA), U11.6 (SDA); also elsewhere on the board
SERVO_5V: R39.1, R42.1, TP31.P$1; also elsewhere on the board
SERVO_PWM: R26.1, TP20.P$1; also elsewhere on the board
TEMP_SENSOR_POWER: C10.1, TP35.P$1, U2.3 (VDD); also elsewhere on the board
VBAT: R17.2; also elsewhere on the board
VBAT_SENSE: C9.1, R17.1, R18.1, TP32.P$1; also elsewhere on the board
VBUS: R3.2; also elsewhere on the board
VBUS_SENSE: C2.1, R3.1, R5.1, TP33.P$1; also elsewhere on the board
VCC: C7.2, R15.1, R24.1, U6.13 (3.3V), U7.3_WP (WP), U7.7_HOLD (HOLD), U7.8_VCC (VCC); also elsewhere on the board
VIN+: C25.1, R41.2, U11.1 (VIN+)
VIN-: C25.2, R42.2, U11.2 (VIN-)

Notes on the sheet:
-- CONFIDENTIAL -- NOT FOR PUBLIC DISTRIBUTION!
Property of AKstudios LLC
v2.2
Akram Ali
I2C Addr 0x40
TEMPERATURE & HUMIDITY SENSOR
SERVO PWM DRIVER
I2C Addr 0x45
RFM69HCW RADIO
SERVO CURRENT MONITOR
BATTERY VOLTAGE MONITOR
VBUS VOLTAGE MONITOR
I2C Addr 0x41
SPI FLASH MEM

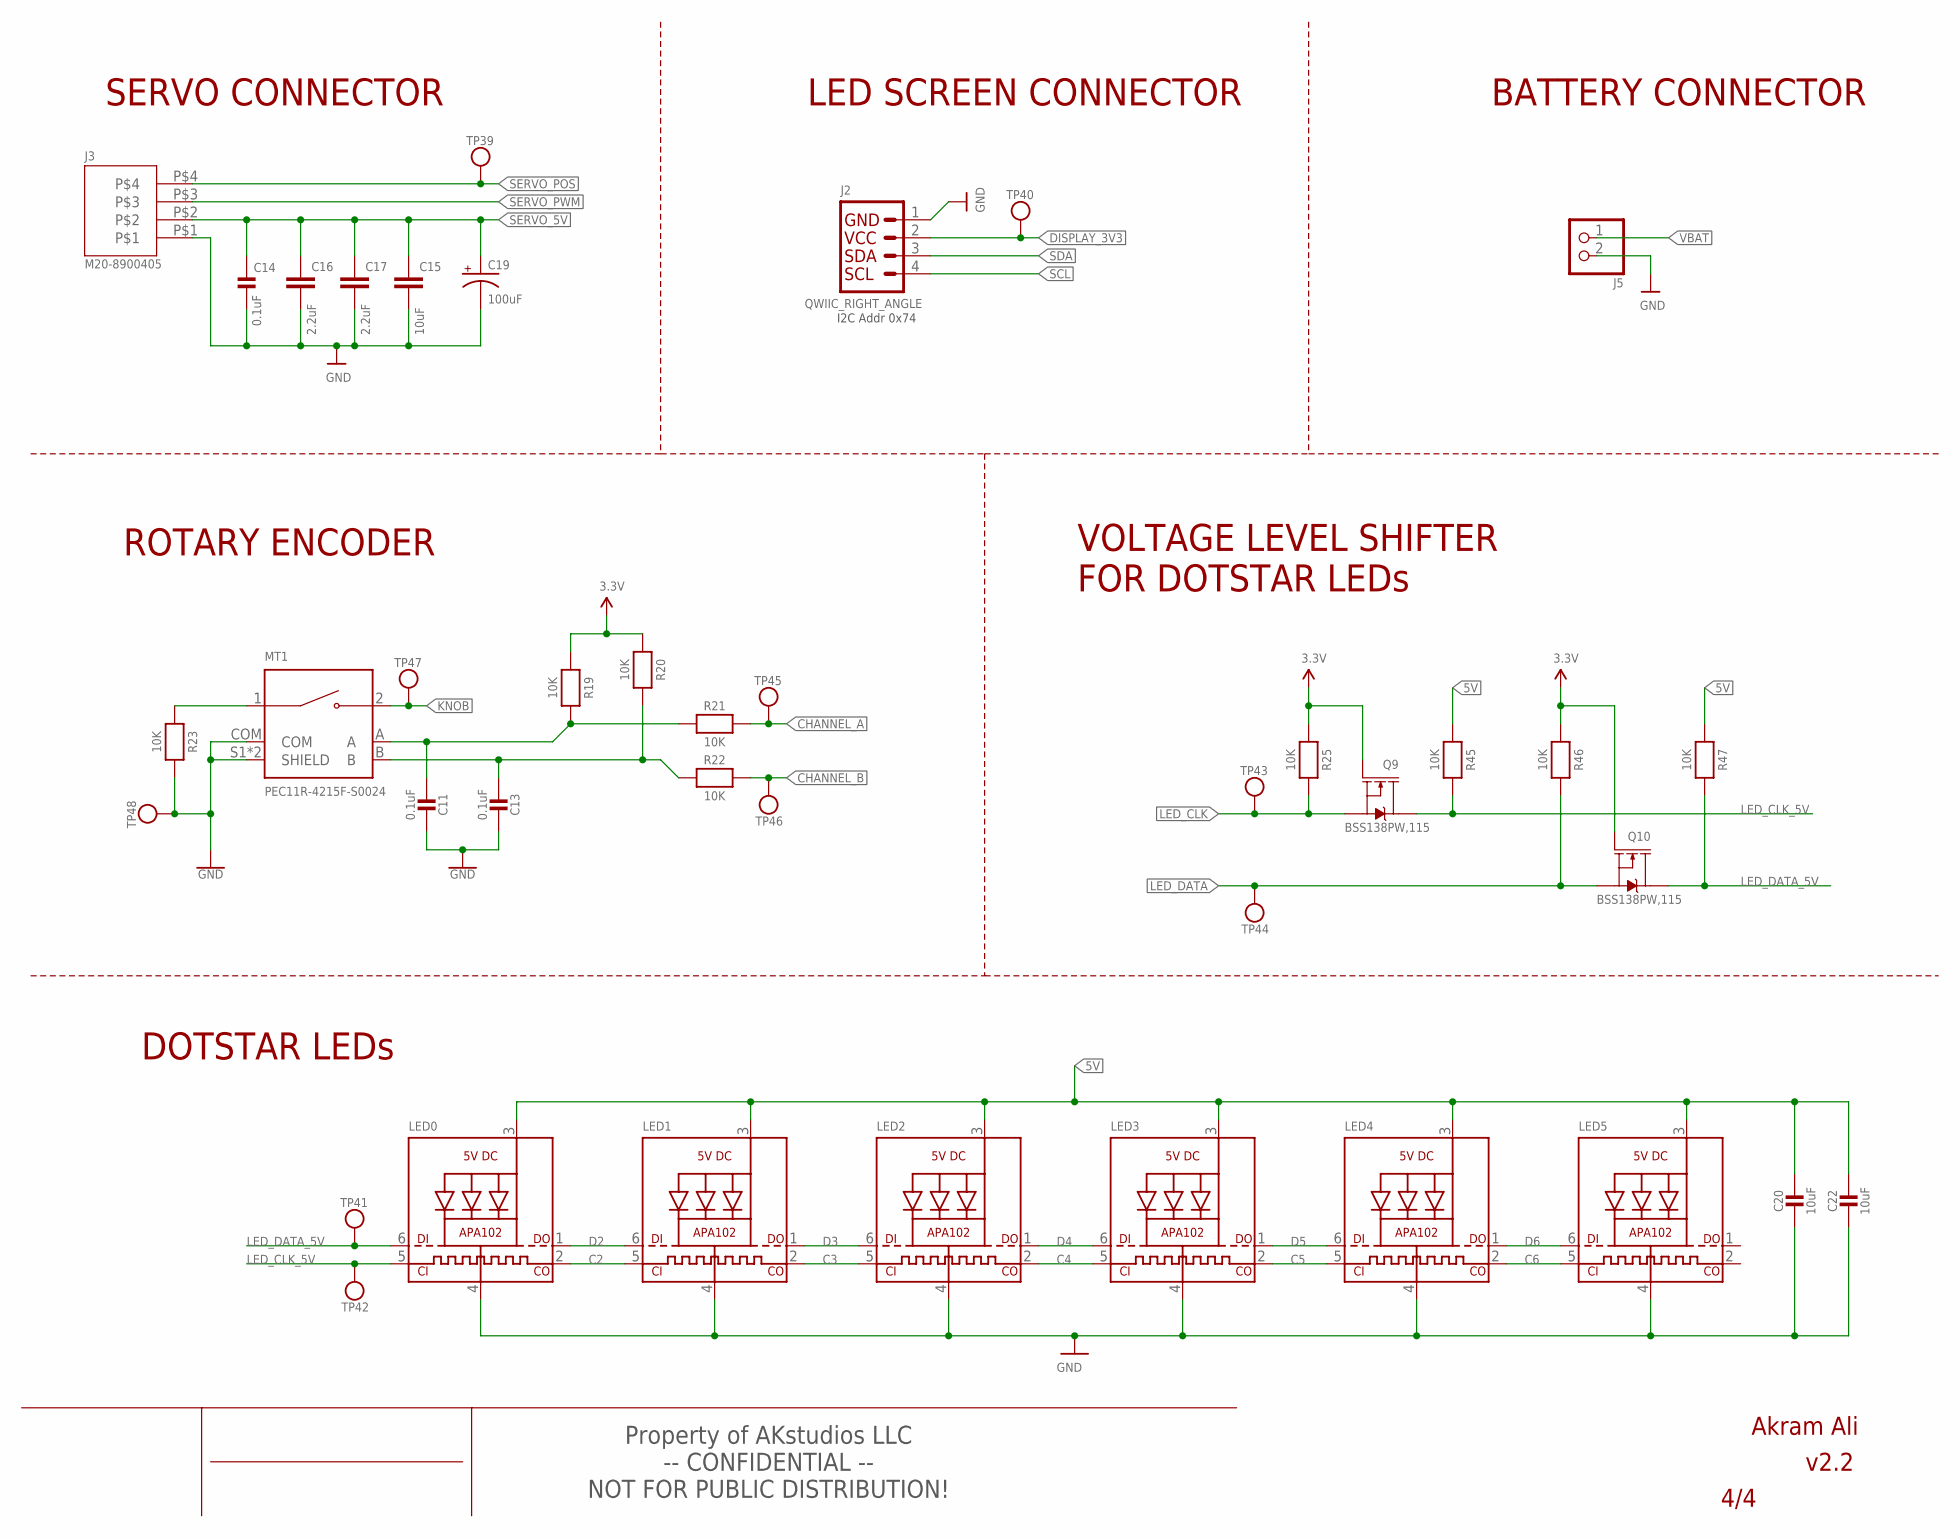
[picture p14: schematic BORC_v2_control_board.sch, sheet 4, Ports, Buttons & LEDs]

Parts:
C11, C13: 0.1uF; MICROBUILDER__0402MP; MPN GRM155R71H104KE14D
C14: 0.1uF; 0805-NO; MPN CC0805KRX7R9BB104
C15: 10uF; 0805; MPN GRM21BR61H106KE43L
C16, C17: 2.2uF; 1206
C19: 100uF; PANASONIC_D; MPN A768EB107M1ELAS036
C20, C22: 10uF; MICROBUILDER__0402MP; MPN GRM155R71H104KE14D
J2: QWIIC_RIGHT_ANGLE; JST04_1MM_RA; MPN SM04B-SRSS-TB(LF)(SN)
J3: M20-8900405; MPN M20-8900405
J5: JST_2PIN-THM-RA; JST-PH-2-THM-RA; MPN S2B-PH-K-S
LED0, LED1, LED2, LED3, LED4, LED5: APA102; APA102_2020; MPN APA102-2020
MT1: PEC11R-4215F-S0024; XDCR_PEC11R-4215F-S0024; MPN PEC11R-4215F-S0024
Q9, Q10: BSS138PW,115; SOT323; MPN BSS138PW,115
R19, R20, R21, R22, R23, R25, R45, R46, R47: 10K; MICROBUILDER__0402MP; MPN RC0402FR-7W10KL
TP39, TP40, TP41, TP42, TP43, TP44, TP45, TP46, TP47, TP48: RX; MICROBUILDER_TESTPOINT_ROUND_1MM

Connections:
5V: C20.1, C22.1, LED0.3 (VDD), LED1.3 (VDD), LED2.3 (VDD), LED3.3 (VDD), LED4.3 (VDD), LED5.3 (VDD), R45.1, R47.1; also elsewhere on the board
A: C11.2, MT1.A, R19.2, R21.1
B: C13.2, MT1.B, R20.2, R22.1
C2: LED0.2 (CKO), LED1.5 (CKI)
C3: LED1.2 (CKO), LED2.5 (CKI)
C4: LED2.2 (CKO), LED3.5 (CKI)
C5: LED3.2 (CKO), LED4.5 (CKI)
C6: LED4.2 (CKO), LED5.5 (CKI)
CHANNEL_A: R21.2, TP45.P$1; also elsewhere on the board
CHANNEL_B: R22.2, TP46.P$1; also elsewhere on the board
D2: LED0.1 (DO), LED1.6 (DI)
D3: LED1.1 (DO), LED2.6 (DI)
D4: LED2.1 (DO), LED3.6 (DI)
D5: LED3.1 (DO), LED4.6 (DI)
D6: LED4.1 (DO), LED5.6 (DI)
DISPLAY_3V3: J2.2, TP40.P$1; also elsewhere on the board
GND: C11.1, C13.1, C14.2, C15.2, C16.2, C17.2, C19.-, C20.2, C22.2, J2.1, J3.P$1, J5.2 (1), LED0.4 (GND), LED1.4 (GND), LED2.4 (GND), LED3.4 (GND), LED4.4 (GND), LED5.4 (GND), MT1.COM, MT1.S1 (SHIELD), MT1.S2 (SHIELD), R23.2, TP48.P$1; also elsewhere on the board
KNOB: MT1.2, TP47.P$1; also elsewhere on the board
LED_CLK: Q9.2 (S), R25.2, TP43.P$1; also elsewhere on the board
LED_CLK_5V: LED0.5 (CKI), Q9.3 (D), R45.2, TP42.P$1
LED_DATA: Q10.2 (S), R46.2, TP44.P$1; also elsewhere on the board
LED_DATA_5V: LED0.6 (DI), Q10.3 (D), R47.2, TP41.P$1
unnamed: MT1.1, R23.1
SCL: J2.4; also elsewhere on the board
SDA: J2.3; also elsewhere on the board
SERVO_5V: C14.1, C15.1, C16.1, C17.1, C19.+, J3.P$2; also elsewhere on the board
SERVO_POS: J3.P$4, TP39.P$1; also elsewhere on the board
SERVO_PWM: J3.P$3; also elsewhere on the board
VBAT: J5.1 (2); also elsewhere on the board
VCC: Q9.1 (G), Q10.1 (G), R19.1, R20.1, R25.1, R46.1; also elsewhere on the board

Notes on the sheet:
ROTARY ENCODER
SERVO CONNECTOR
BATTERY CONNECTOR
LED SCREEN CONNECTOR
DOTSTAR LEDs
VOLTAGE LEVEL SHIFTER FOR DOTSTAR LEDs
-- CONFIDENTIAL -- NOT FOR PUBLIC DISTRIBUTION!
Property of AKstudios LLC
v2.2
Akram Ali
I2C Addr 0x74

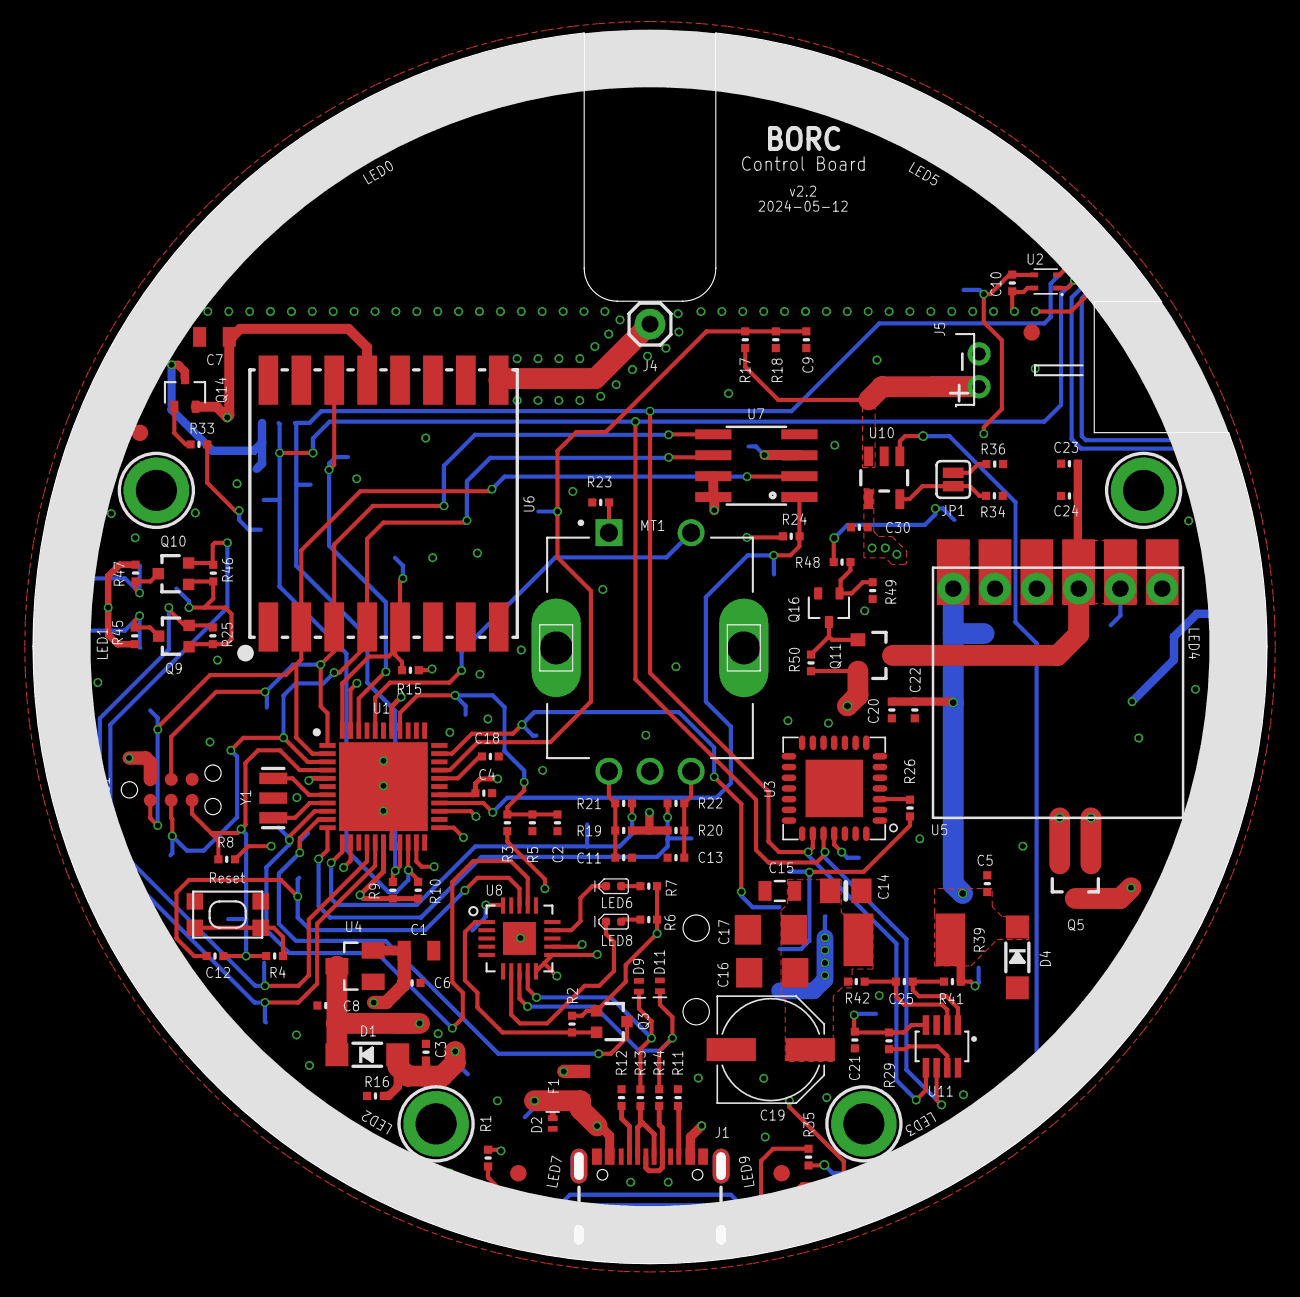
[picture p15: board BORC_v2_control_board.brd from above]

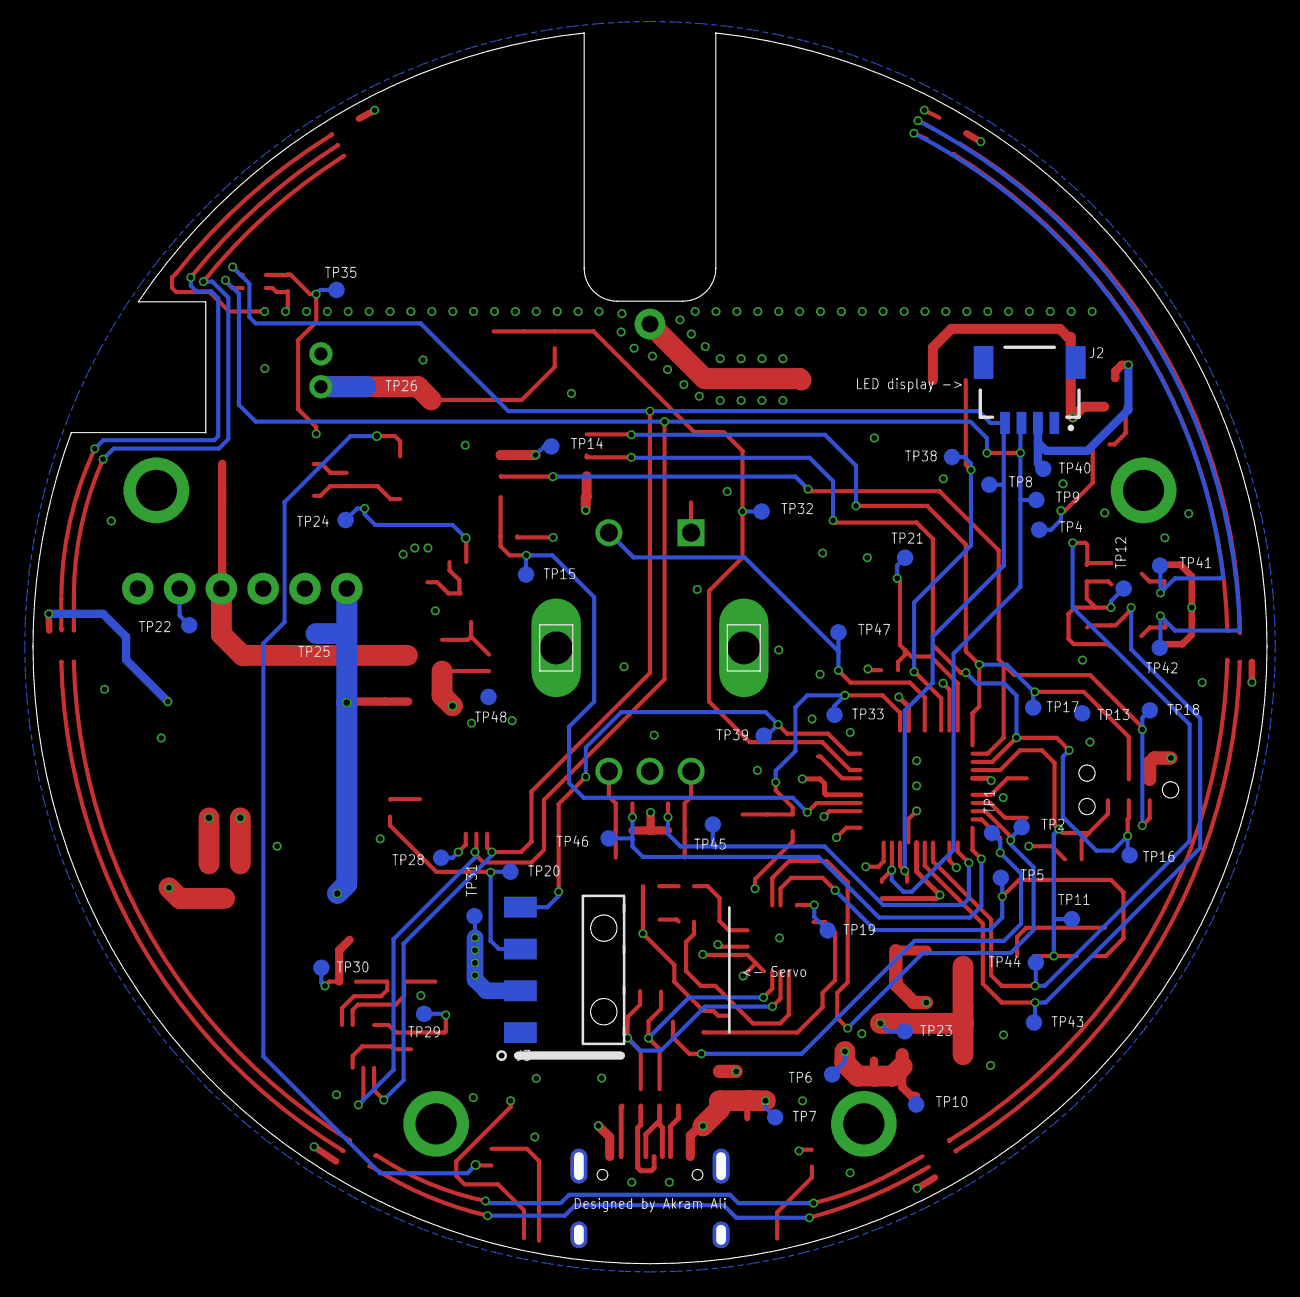
[picture p16: board BORC_v2_control_board.brd from below]

Board: 4 copper layers, 75.0 x 74.8 mm, 160 parts (45 on the bottom side), 80 nets.
