radiator-revivers/BORC/hardware/LED_Board/LED_board.brd

## EAGLE design hardware/LED_Board/LED_board.brd (2024-05-08)

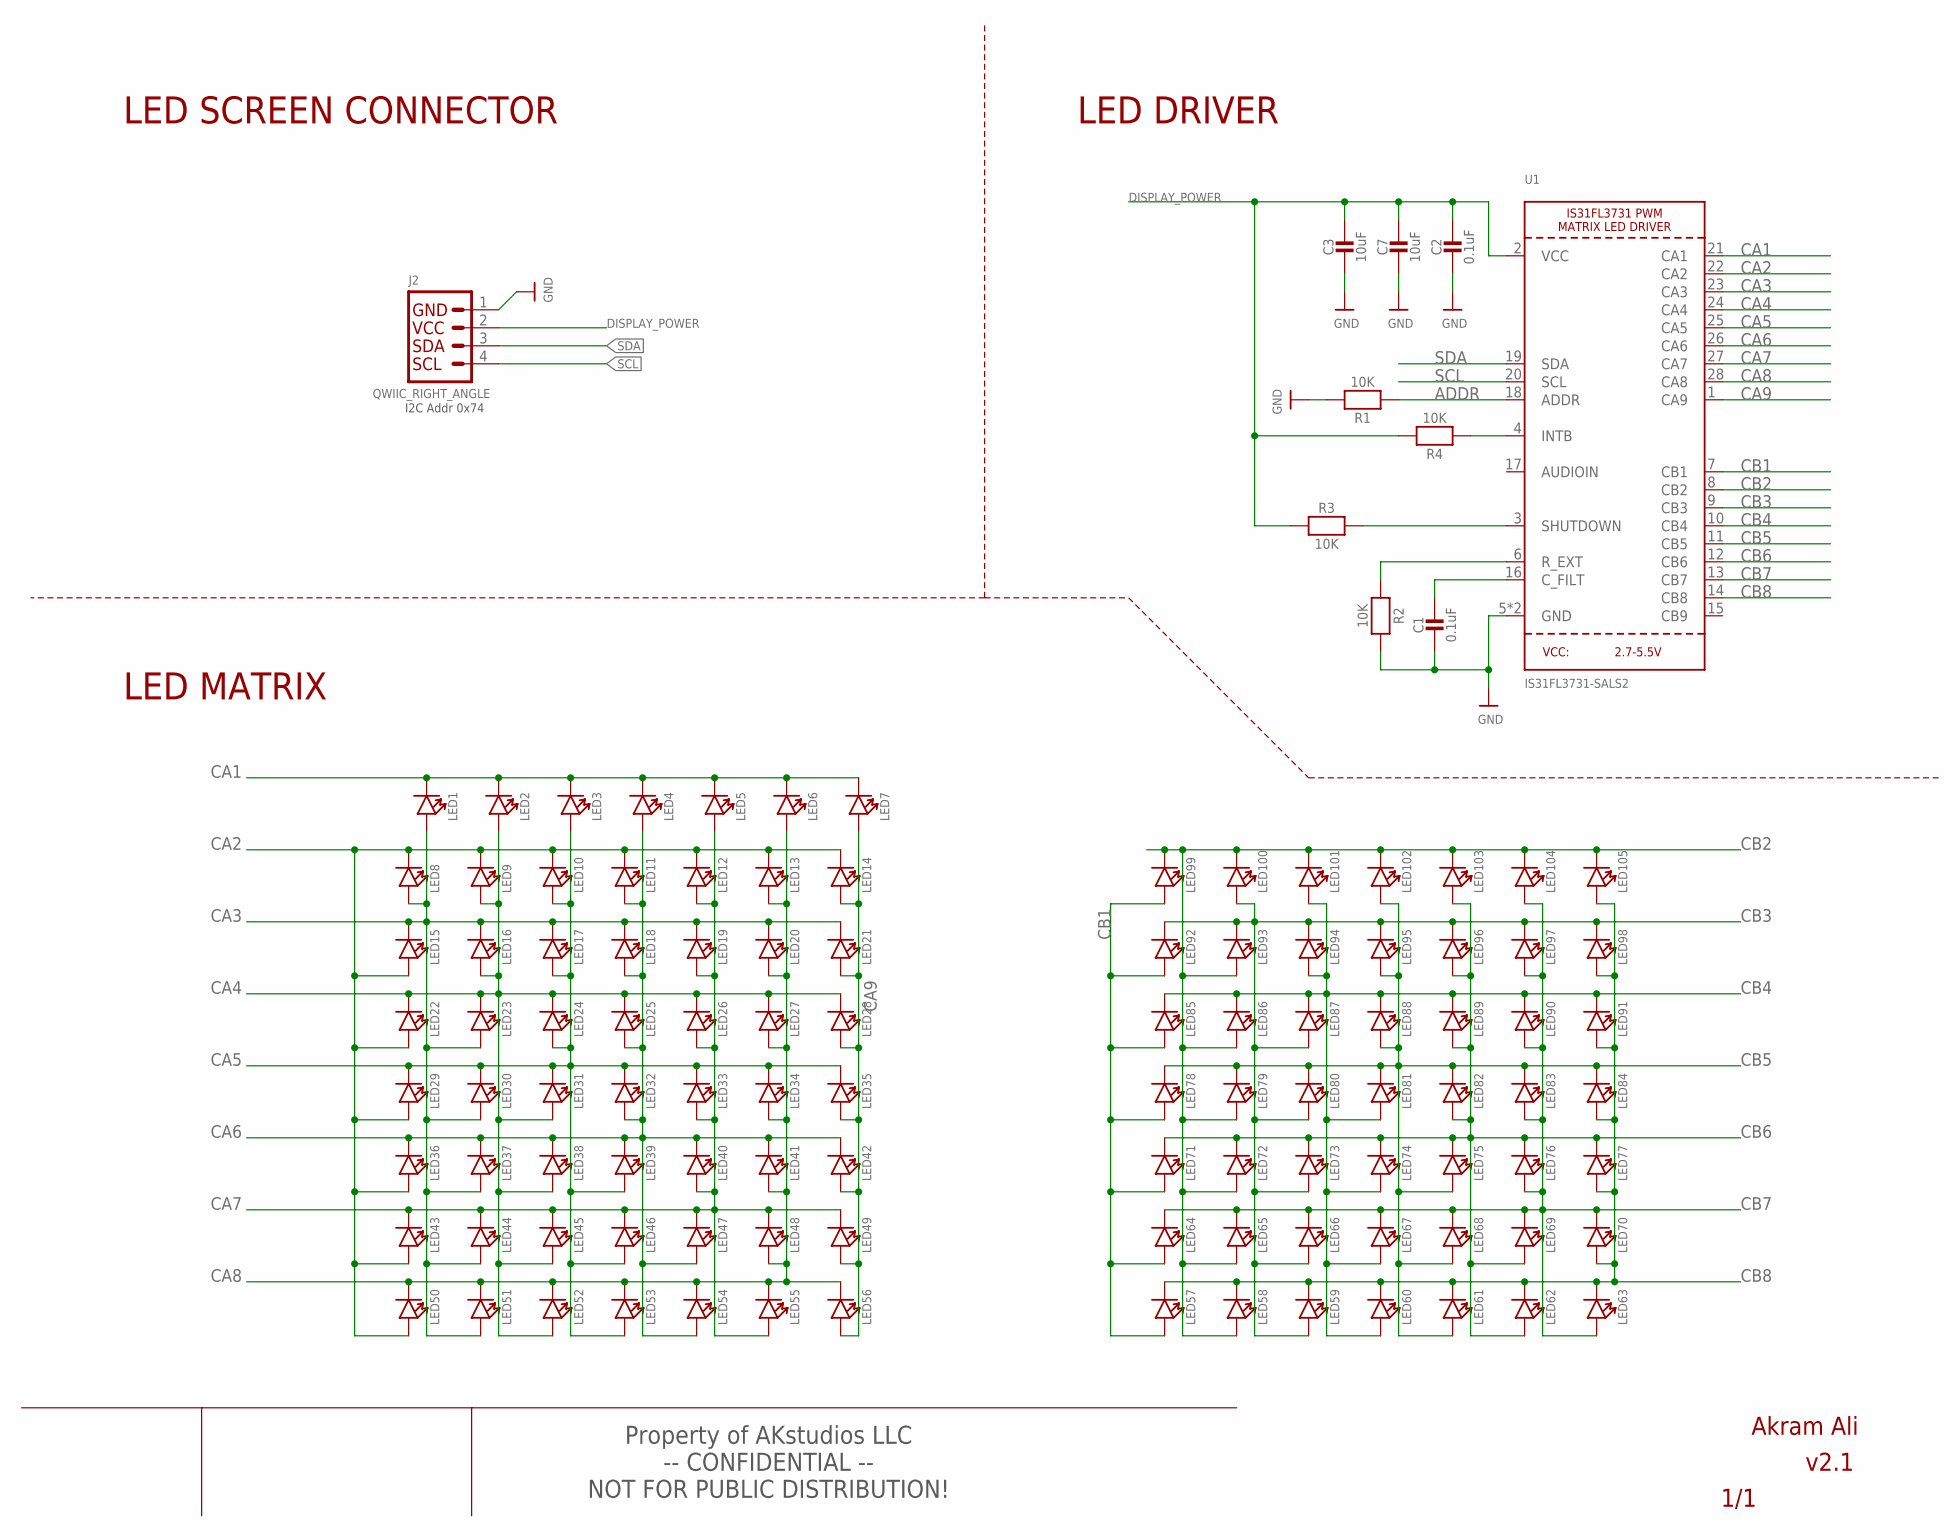
[picture p17: schematic LED_board.sch, LED matrix and driver]

Parts:
C1, C2: 0.1uF; MICROBUILDER__0402MP; MPN GRM155R71C104KA88J
C3, C7: 10uF; MICROBUILDER__0402MP; MPN GRM155R71C104KA88J
J2: QWIIC_RIGHT_ANGLE; JST04_1MM_RA; MPN SM04B-SRSS-TB(LF)(SN)
LED1, LED2, LED3, LED4, LED5, LED6, LED7, LED8, LED9, LED10, LED11, LED12, LED13, LED14, LED15, LED16, LED17, LED18, LED19, LED20, LED21, LED22, LED23, LED24, LED25, LED26, LED27, LED28, LED29, LED30, LED31, LED32, LED33, LED34, LED35, LED36, LED37, LED38, LED39, LED40, LED41, LED42, LED43, LED44, LED45, LED46, LED47, LED48, LED49, LED50, LED51, LED52, LED53, LED54, LED55, LED56, LED57, LED58, LED59, LED60, LED61, LED62, LED63, LED64, LED65, LED66, LED67, LED68, LED69, LED70, LED71, LED72, LED73, LED74, LED75, LED76, LED77, LED78, LED79, LED80, LED81, LED82, LED83, LED84, LED85, LED86, LED87, LED88, LED89, LED90, LED91, LED92, LED93, LED94, LED95, LED96, LED97, LED98, LED99, LED100, LED101, LED102, LED103, LED104, LED105: SMD-LED-CLEAR-BLUE(0402); LED-0402; MPN IN-S42ATUW
R1, R2, R3, R4: 10K; MICROBUILDER__0402MP; MPN RC0402FR-7W10KL
U1: IS31FL3731-SALS2; QFN28_4MM_0.4MM

Connections:
ADDR: R1.1, U1.18 (ADDR)
CA1: LED1.-, LED2.-, LED3.-, LED4.-, LED5.-, LED6.-, LED7.-, U1.21 (CA1)
CA2: LED8.-, LED9.-, LED10.-, LED11.-, LED12.-, LED13.-, LED14.-, LED15.+, LED22.+, LED29.+, LED36.+, LED43.+, LED50.+, U1.22 (CA2)
CA3: LED1.+, LED8.+, LED15.-, LED16.-, LED17.-, LED18.-, LED19.-, LED20.-, LED21.-, LED23.+, LED30.+, LED37.+, LED44.+, LED51.+, U1.23 (CA3)
CA4: LED2.+, LED9.+, LED16.+, LED22.-, LED23.-, LED24.-, LED25.-, LED26.-, LED27.-, LED28.-, LED31.+, LED38.+, LED45.+, LED52.+, U1.24 (CA4)
CA5: LED3.+, LED10.+, LED17.+, LED24.+, LED29.-, LED30.-, LED31.-, LED32.-, LED33.-, LED34.-, LED35.-, LED39.+, LED46.+, LED53.+, U1.25 (CA5)
CA6: LED4.+, LED11.+, LED18.+, LED25.+, LED32.+, LED36.-, LED37.-, LED38.-, LED39.-, LED40.-, LED41.-, LED42.-, LED47.+, LED54.+, U1.26 (CA6)
CA7: LED5.+, LED12.+, LED19.+, LED26.+, LED33.+, LED40.+, LED43.-, LED44.-, LED45.-, LED46.-, LED47.-, LED48.-, LED49.-, LED55.+, U1.27 (CA7)
CA8: LED6.+, LED13.+, LED20.+, LED27.+, LED34.+, LED41.+, LED48.+, LED50.-, LED51.-, LED52.-, LED53.-, LED54.-, LED55.-, LED56.-, U1.28 (CA8)
CA9: LED7.+, LED14.+, LED21.+, LED28.+, LED35.+, LED42.+, LED49.+, LED56.+, U1.1 (CA9)
CB1: LED57.+, LED64.+, LED71.+, LED78.+, LED85.+, LED92.+, LED99.+, U1.7 (CB1)
CB2: LED58.+, LED65.+, LED72.+, LED79.+, LED86.+, LED93.+, LED99.-, LED100.-, LED101.-, LED102.-, LED103.-, LED104.-, LED105.-, U1.8 (CB2)
CB3: LED59.+, LED66.+, LED73.+, LED80.+, LED87.+, LED92.-, LED93.-, LED94.-, LED95.-, LED96.-, LED97.-, LED98.-, LED100.+, U1.9 (CB3)
CB4: LED60.+, LED67.+, LED74.+, LED81.+, LED85.-, LED86.-, LED87.-, LED88.-, LED89.-, LED90.-, LED91.-, LED94.+, LED101.+, U1.10 (CB4)
CB5: LED61.+, LED68.+, LED75.+, LED78.-, LED79.-, LED80.-, LED81.-, LED82.-, LED83.-, LED84.-, LED88.+, LED95.+, LED102.+, U1.11 (CB5)
CB6: LED62.+, LED69.+, LED71.-, LED72.-, LED73.-, LED74.-, LED75.-, LED76.-, LED77.-, LED82.+, LED89.+, LED96.+, LED103.+, U1.12 (CB6)
CB7: LED63.+, LED64.-, LED65.-, LED66.-, LED67.-, LED68.-, LED69.-, LED70.-, LED76.+, LED83.+, LED90.+, LED97.+, LED104.+, U1.13 (CB7)
CB8: LED57.-, LED58.-, LED59.-, LED60.-, LED61.-, LED62.-, LED63.-, LED70.+, LED77.+, LED84.+, LED91.+, LED98.+, LED105.+, U1.14 (CB8)
DISPLAY_POWER: C2.1, C3.1, C7.1, J2.2, R3.1, R4.2, U1.2 (VCC)
GND: C1.2, C2.2, C3.2, C7.2, J2.1, R1.2, R2.2, U1.5 (GND), U1.THERMAL (GND)
unnamed: R3.2, U1.3 (SHUTDOWN)
unnamed: C1.1, U1.16 (C_FILT)
unnamed: R4.1, U1.4 (INTB)
R_EXT: R2.1, U1.6 (R_EXT)
SCL: J2.4, U1.20 (SCL)
SDA: J2.3, U1.19 (SDA)

Notes on the sheet:
LED SCREEN CONNECTOR
I2C Addr 0x74
-- CONFIDENTIAL -- NOT FOR PUBLIC DISTRIBUTION!
Property of AKstudios LLC
v2.1
Akram Ali
LED DRIVER
LED MATRIX

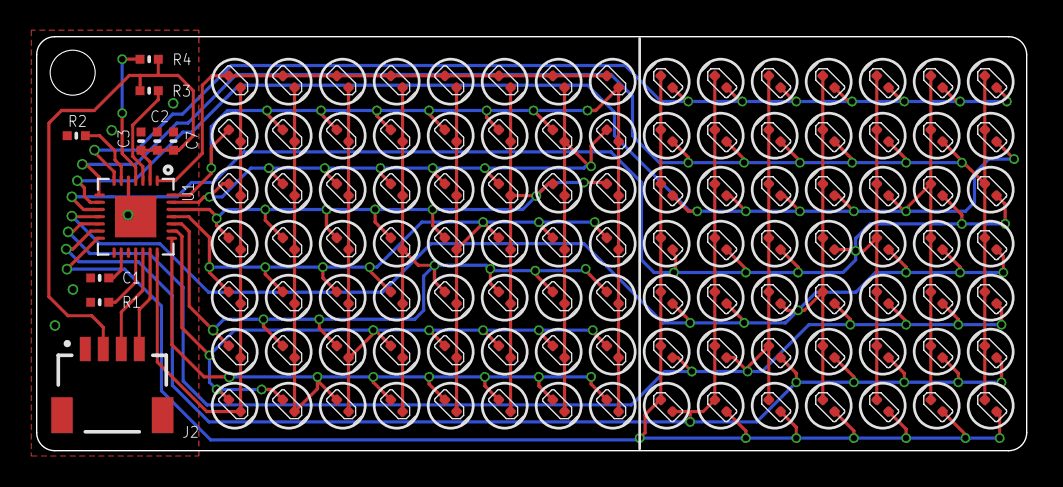
[picture p18: board LED_board.brd from above]

Board: 4 copper layers, 55.0 x 23.0 mm, 115 parts (0 on the bottom side), 26 nets.
