radiator-revivers/BORC/(commit log)

2024-05-08 LED board v2.1 - replaced with 0402 LEDs, arranged in 3x2.5 mm grid, increased width of board to 55 mm
    [LED_Board_BOM.xlsx, LED_board.brd, LED_board.sch]
2024-05-08 LED board updated to v2.1
    - Changed 0603 LEDs to 0402
    - Arranged LEDs in grid of 3 x 2.5 mm spacing
    - Increased board width from 50 to 55mm to accommodate spacing
    - Rerouted all traces to LEDs again for new spacing (needs to be verified; v2.0 worked)
    - ERC/DRC done
    - Added BOM
    - Updated gerbers, renders, schematic, dimensions
    [LED_Board_BOM.xlsx, LED_board.brd, LED_board.sch]
2024-05-12 v2.2 - bug fixes
    - Fixed display power circuit with PNP (active low)
    - Replace charger with MCP73781 (can toggle between 500mA and 1000mA with jumper)
    - Fixed battery JST with PH connector
    - Fixed 5V switch to switch before 5V boost instead of after to avoid voltage drop
    - Merged 5V power with LED power
    - Connected USB shield to ground
    - Connected rotary encoder shield to ground
    - Removed blue LED from 5V power to avoid voltage drop
    - Thickened some power traces where needed
    - Minor adjustments to traces, component placement and silkscreen to accommodate design changes
    - Thickened mounting holes
    - Added visible ground silkscreen for servo
    - Renamed LEDs to match dotstar in code
    - Better info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
    [BORC_v2_control_board.brd, BORC_v2_control_board.sch, BORC_v2_control_board__BOM.xlsx]
